yeoungseon/capstone/README.md

# capstone

Rocker-bogie 메커니즘을 이용한 식음료 배송 AMR

https://o365seoultech-my.sharepoint.com/:f:/g/personal/20110008_officestu_seoultech_ac_kr/EoON9EHYUJFPtbteJweAxmIBQ9wWiIXo9gfmbBEfmd8qZg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
