yeoungseon/capstone/2023/주간보고서/230330 주간보고서.pdf

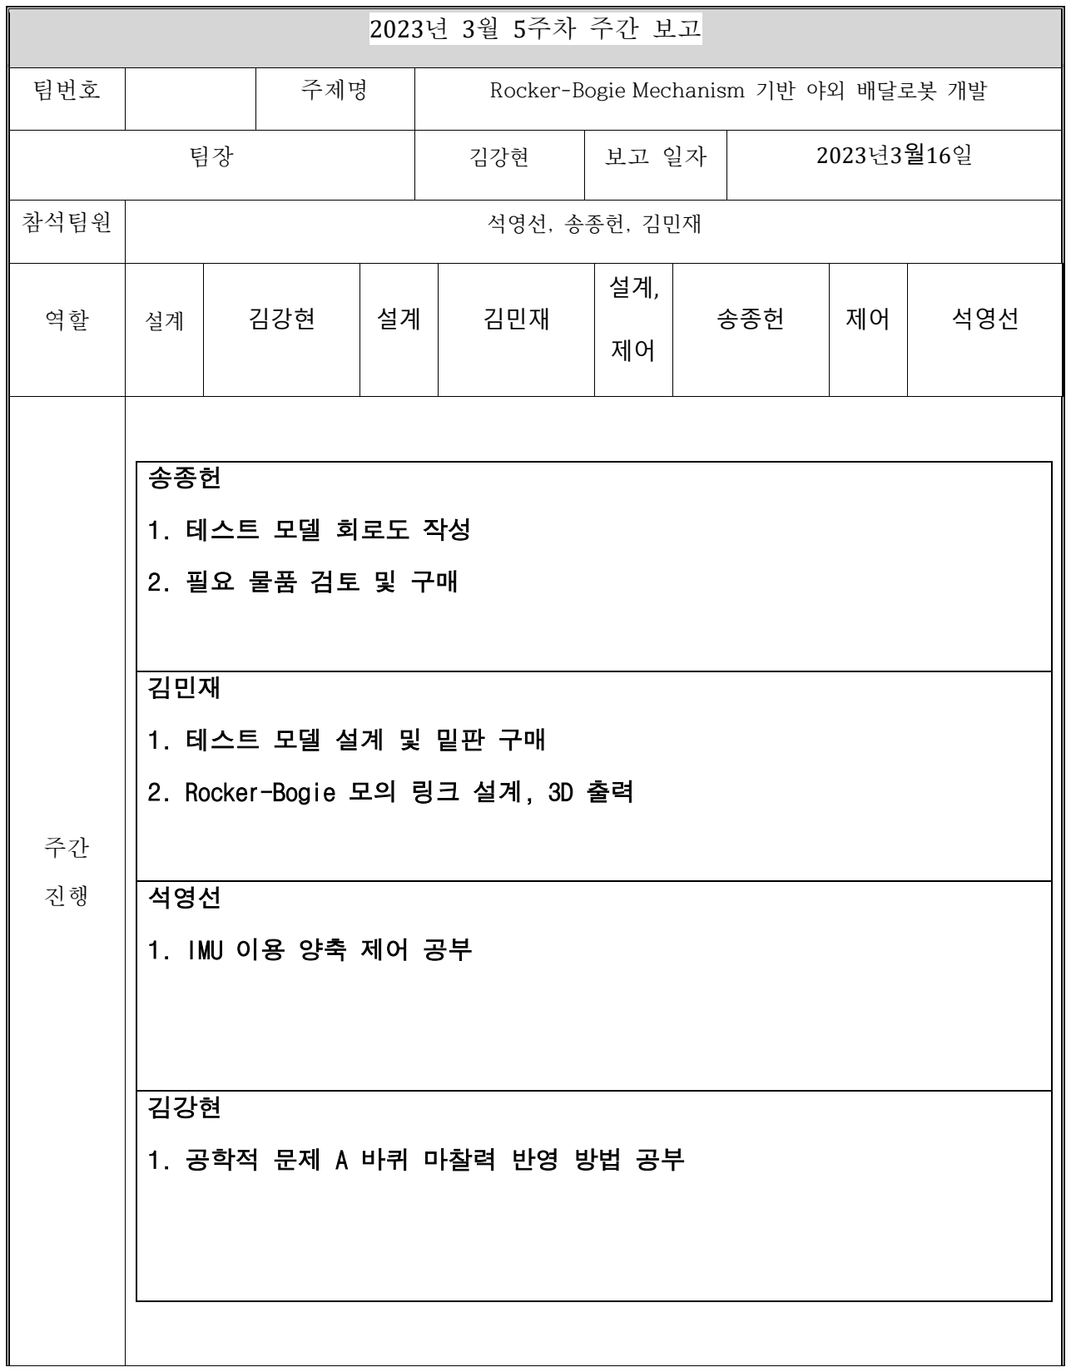
[picture p1: figure]
김강현; 참석팀원; 석영선, 송종헌, 김민재; 김민재; 송종헌; 석영선; 1. 테스트 모델 회로도 작성; 1. 테스트 모델 설계 및 밑판 구매; 2. Rocker-Bogie 모의 링크 설계, 3D 출력; 1. IMU 이용 양축 제어 공부; 1. 공학적 문제 A 바퀴 마찰력 반영 방법 공부

팀번호 | | 주제명 | Rocker-Bogie Mechanism 기반 야외 배달로봇 개발

차주

진행

송종헌

테스트 모델 회로 구성 및 작동 프로그래밍

김민재

테스트 모델 조립, 실 작품 라이다 및 배터리 배치 공부

석영선

테스트 모델 작동 프로그래밍, 카고 제어 공부

김강현

테스트 모델 조립
