yeoungseon/capstone/2023/주간보고서/230413 주간보고서.pdf

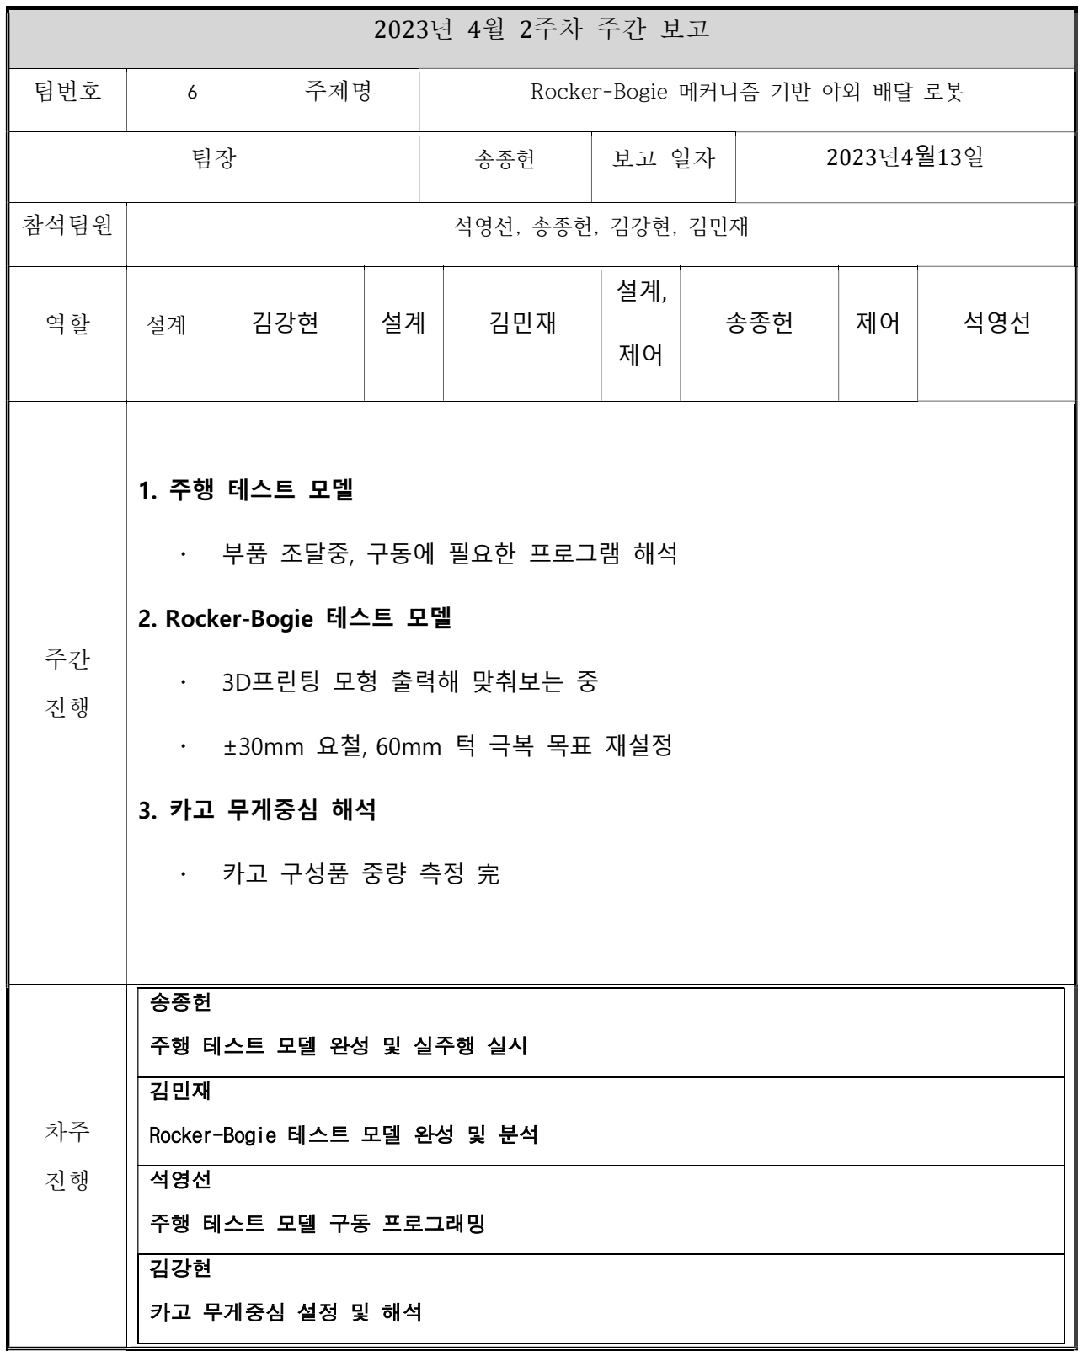
[picture p2: figure]
팀번호; 주제명; Rocker-Bogie 메커니즘 기반 야외 배달 로봇; 송종헌; 참석팀원; 석영선, 송종헌, 김강현, 김민재; 김강현; 김민재; 석영선; 1. 주행 테스트 모델; 부품 조달중, 구동에 필요한 프로그램 해석; 2. Rocker-Bogie 테스트 모델; 3D프린팅 모형 출력해 맞춰보는 중; ±30mm 요철, 60mm 턱 극복 목표 재설정; 3. 카고 무게중심 해석; 카고 구성품 중량 측정 完; 주행 테스트 모델 완성 및 실주행 실시; Rocker-Bogie 테스트 모델 완성 및 분석; 주행 테스트 모델 구동 프로그래밍; 카고 무게중심 설정 및 해석
