yeoungseon/capstone/2023/주간보고서/230512 주간보고서.pdf

2023년 5월 2주차 주간 보고

팀 번호 | 6 | 주제명 | Rocker-Bogie 메커니즘 기반 야외 배달 로봇
팀장 | 송종헌 | 보고 일자 | 2023. 5. 12.
참석 팀원 | 송종헌, 석영선, 김강현, 김민재
역학 | 설계 | 김강현 | 설계 | 김민재 | 설계, 제어 | 송종헌 | 제어 | 석영선
주간 진행 | 김강현 - 축 강성 해석, Cargo 화물 추가 배치 김민재 - 링크 조합에 대한 실험적 해석, 최적링크 도출 송종헌 - 모터 문제 해결, Cargo 프레임 도입 및 Sheet Metal Design 석영선 - 모터 문제 해결, Info Layer 작동상황 확인
차주 진행 | 김강현, 김민재, 송종헌 - 최종 상세 설계안 조율 석영선 - IMU 정보획득 스터디
