yeoungseon/capstone/2023/심사자료/1차발표 최종본.pdf

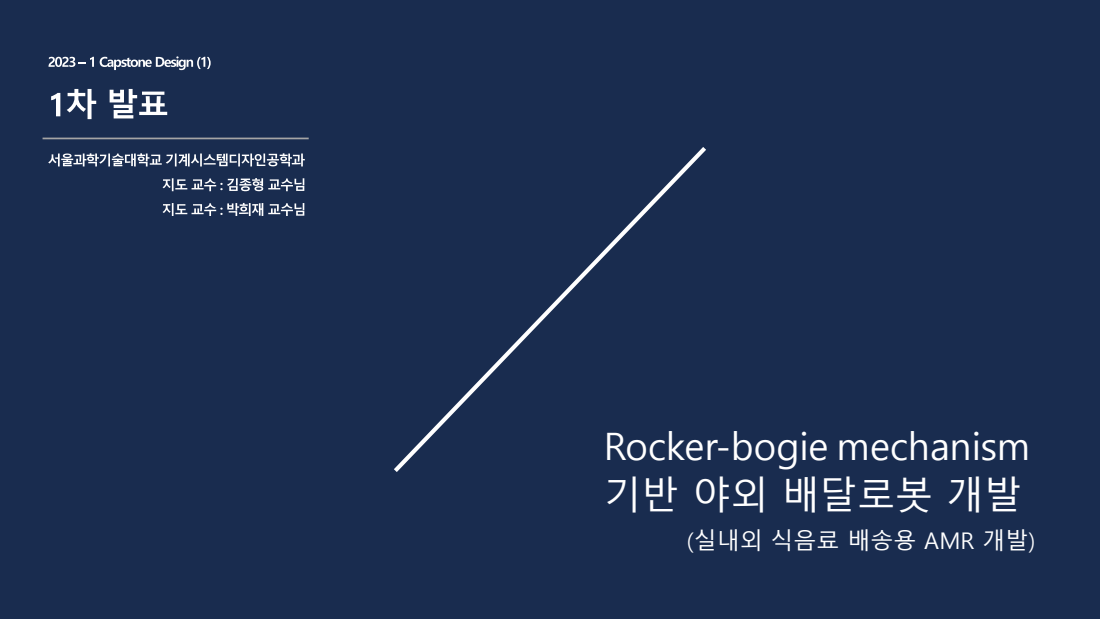
[picture p32: page 1]

Rocker-bogie mechanism
기반 야외 배달로봇 개발

(실내외 식음료 배송용 AMR 개발)

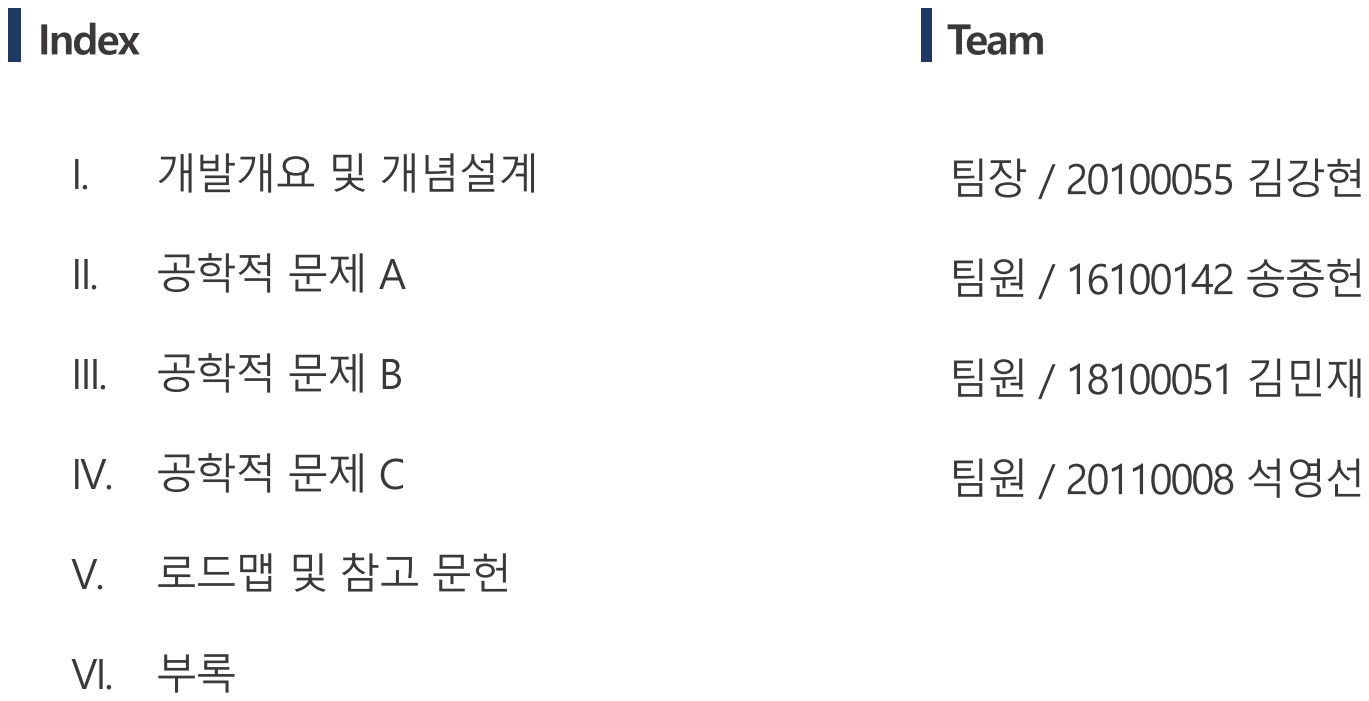
[picture p33: page 2]

### 개발 개요 및

### 개념 설계

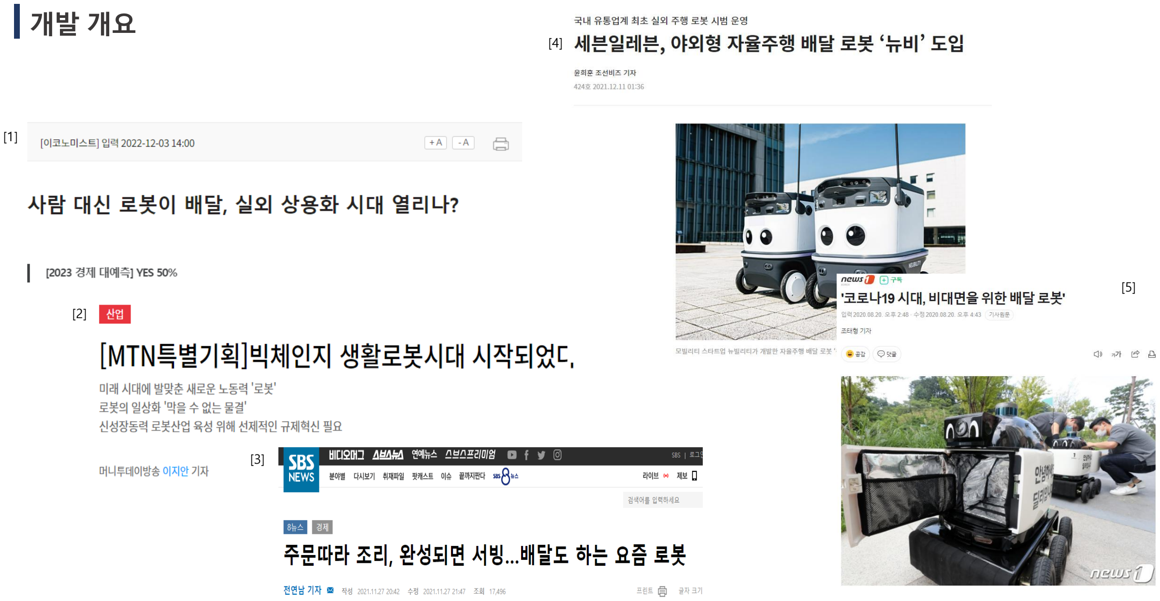
[picture p34: page 4]

[1]

[2]

[3]

[4]

[5]

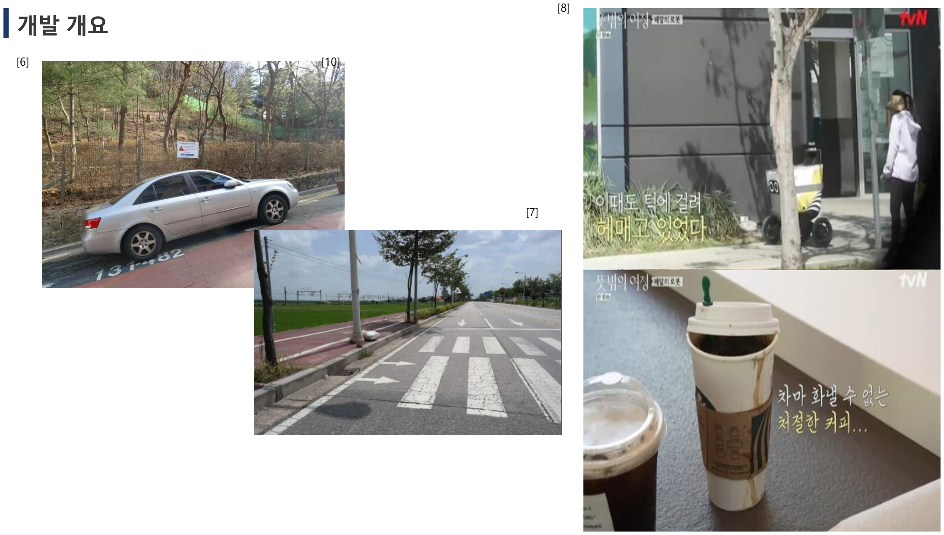
[picture p35: page 5]

[6] [10]

[7]

[8]

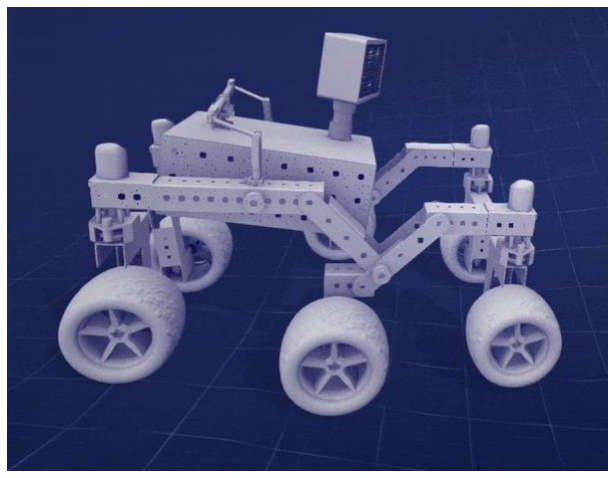
[picture p36: figure]

[9] [10]
+

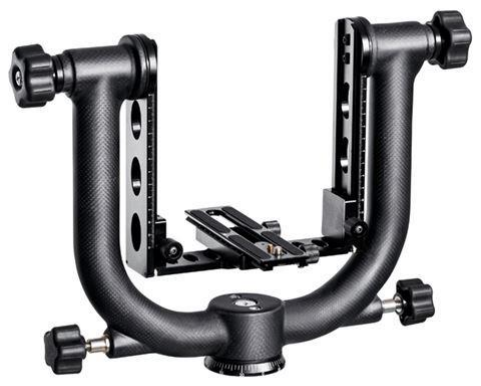
[picture p37: figure]

- 평탄하지 않은 지면에서 접지력과 안정성, 돌파 능력을 제공하는 Rocker-Bogie
- 외부에서 들어오는 기울어짐을 반대로 상쇄하는 Swing식 짐벌 메커니즘
- 이를 종합하면 더 다양한 환경에서 안정적인 배송이 가능할 것

- 시나리오 환경에서 험지 주파에 장애가 없는 동시에 흔들림을 최소화할 수 있 는 음료배달로봇
- 음식이 아닌 음료배달을 목적으로 선정한 이유 : 눈으로 확인하기 쉽고 스테빌 라이저 효과를 가장 잘 이용할 수 있을 것이라고 예상 됨

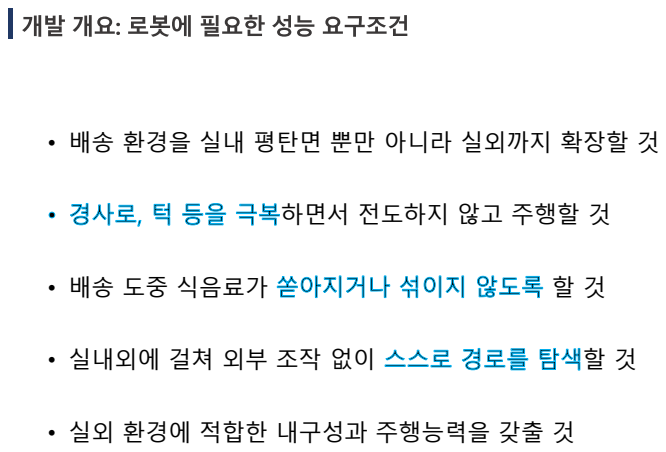
[picture p38: page 8]
• 배송 도중 식음료가; • 실내외에 걸쳐 외부 조작 없이

• 배송 환경을 실내 평탄면 뿐만 아니라 실외까지 확장할 것

하면서 전도하지 않고 주행할 것

• 실외 환경에 적합한 내구성과 주행능력을 갖출 것

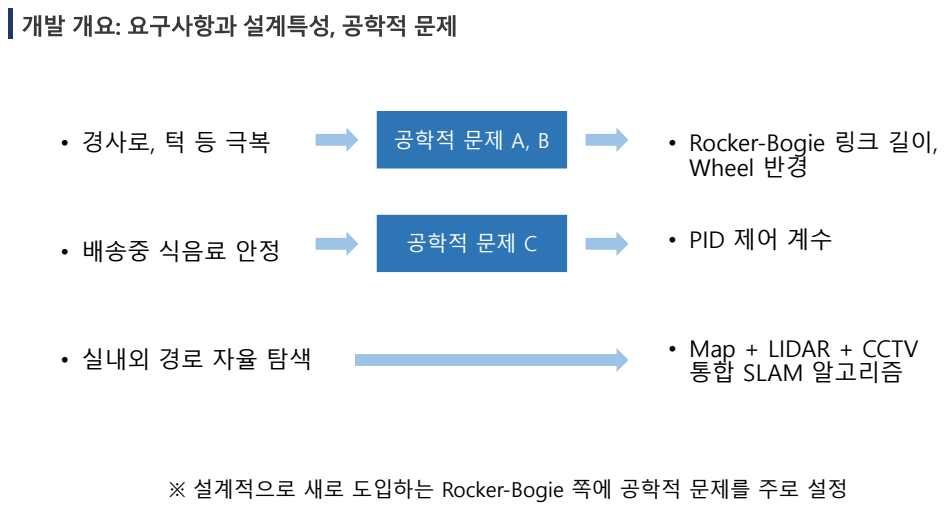
[picture p39: page 9]
• 경사로, 턱 등 극복; 공학적 문제 A, B; 공학적 문제 C

• Rocker-Bogie 링크 길이,
Wheel 반경

• PID 제어 계수

• 배송중 식음료 안정

• Map + LIDAR + CCTV
통합 SLAM 알고리즘

• 실내외 경로 자율 탐색

※ 설계적으로 새로 도입하는 Rocker-Bogie 쪽에 공학적 문제를 주로 설정

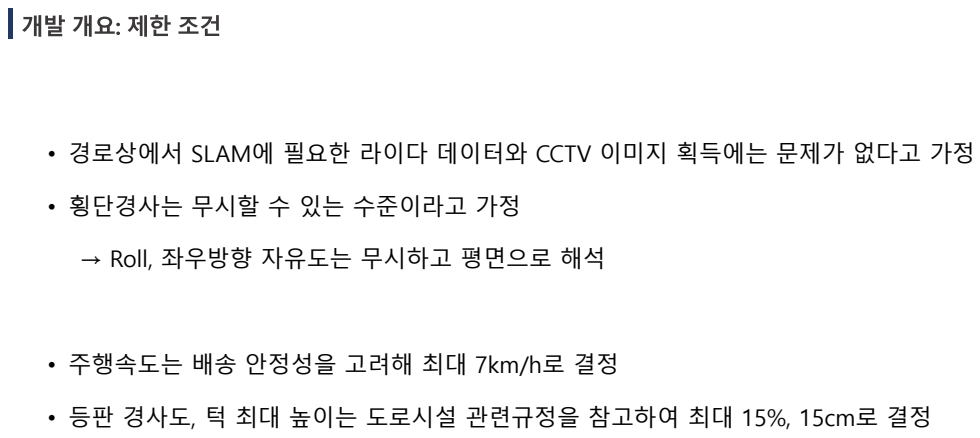
[picture p40: page 10]

• 경로상에서 SLAM에 필요한 라이다 데이터와 CCTV 이미지 획득에는 문제가 없다고 가정

• 횡단경사는 무시할 수 있는 수준이라고 가정

→ Roll, 좌우방향 자유도는 무시하고 평면으로 해석

• 주행속도는 배송 안정성을 고려해 최대 7km/h로 결정

• 등판 경사도, 턱 최대 높이는 도로시설 관련규정을 참고하여 최대 15%, 15cm로 결정

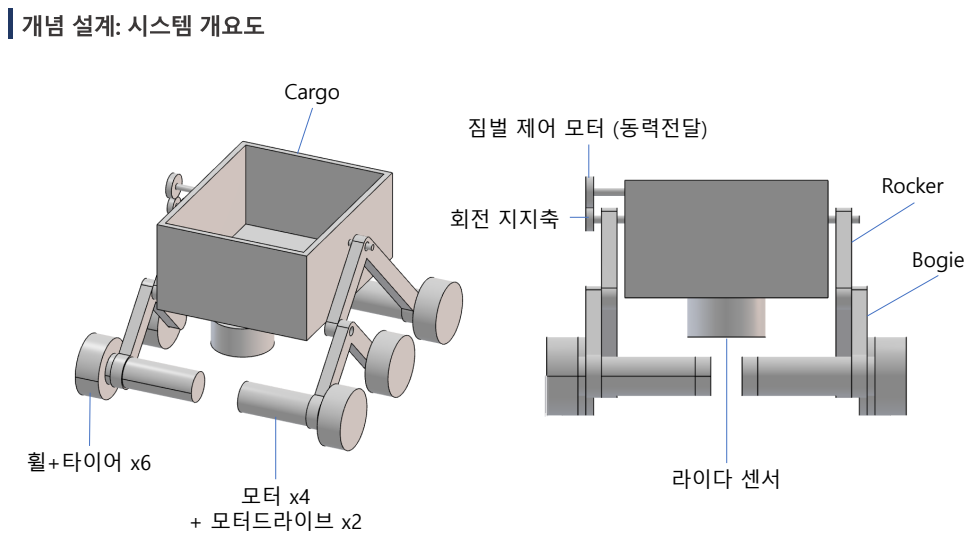
[picture p41: page 11]
회전 지지축; Cargo; + 모터드라이브 x2; 휠+타이어 x6; Rocker; Bogie

짐벌 제어 모터 (동력전달)

라이다 센서 모터 x4

- CCTV가 갖춰진 실내에서 모의 주행 환경으로 테스트
- A - 경사로 극복 → B - 턱 극복 → C - 장애물 회피
- 전체 과정에서 경로 탐색, 음료의 안정성 유지를 지속 수행
🏴 | 🏴

평가: 배송된 음료의 상태,
배송 중 경로 이탈 여부

A코스: 15% 경사면

B코스: 15cm 턱

C코스: 장애물 인식·회피

- 링크와 다중 구동륜을 이용한 Rocker-Bogie 메커니즘을 사용

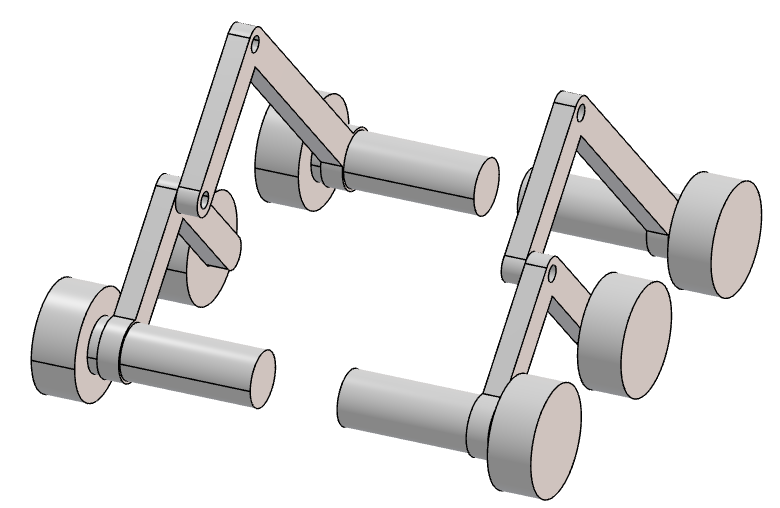
[picture p42: figure]
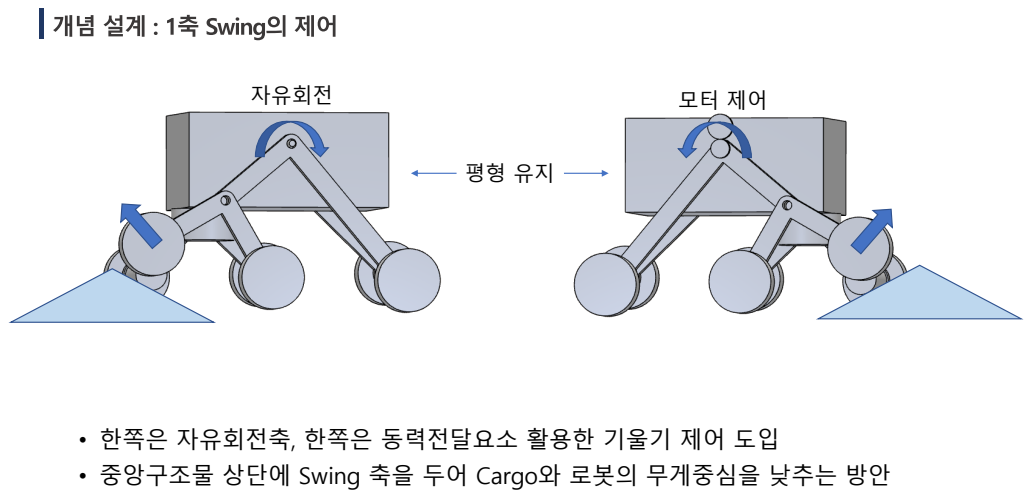
[picture p43: page 14]
자유회전

• 한쪽은 자유회전축, 한쪽은 동력전달요소 활용한 기울기 제어 도입
• 중앙구조물 상단에 Swing 축을 두어 Cargo와 로봇의 무게중심을 낮추는 방안

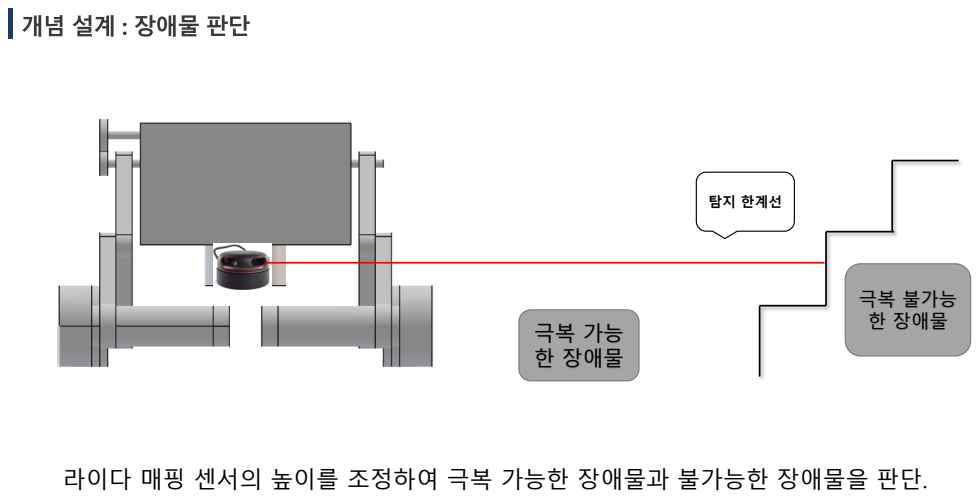
[picture p44: page 15]
극복 가능 한 장애물; 탐지 한계선; 극복 불가능 한 장애물

라이다 매핑 센서의 높이를 조정하여 극복 가능한 장애물과 불가능한 장애물을 판단.

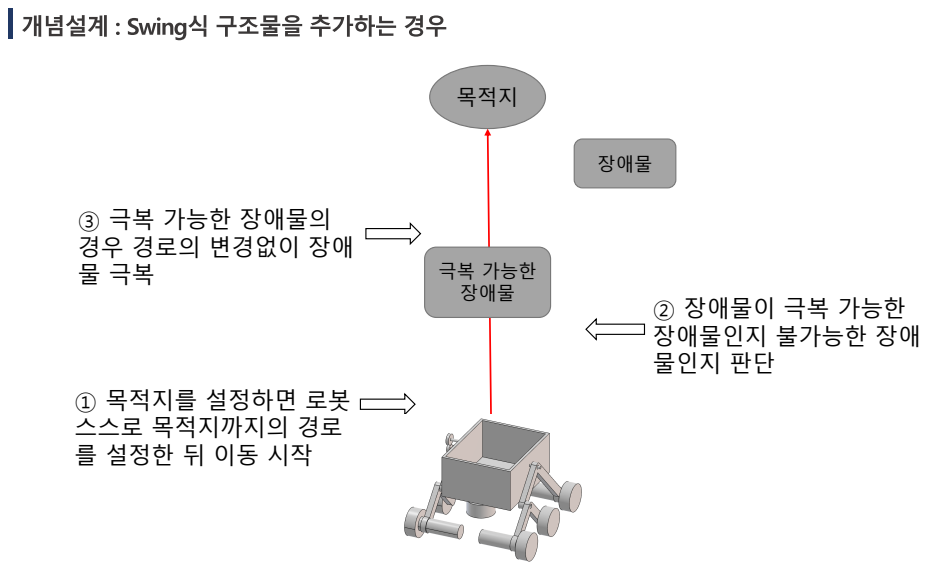
[picture p45: page 16]
극복 가능한 장애물; 목적지; 장애물

③ 극복 가능한 장애물의
경우 경로의 변경없이 장애

② 장애물이 극복 가능한
장애물인지 불가능한 장애
물인지 판단

① 목적지를 설정하면 로봇
스스로 목적지까지의 경로
를 설정한 뒤 이동 시작

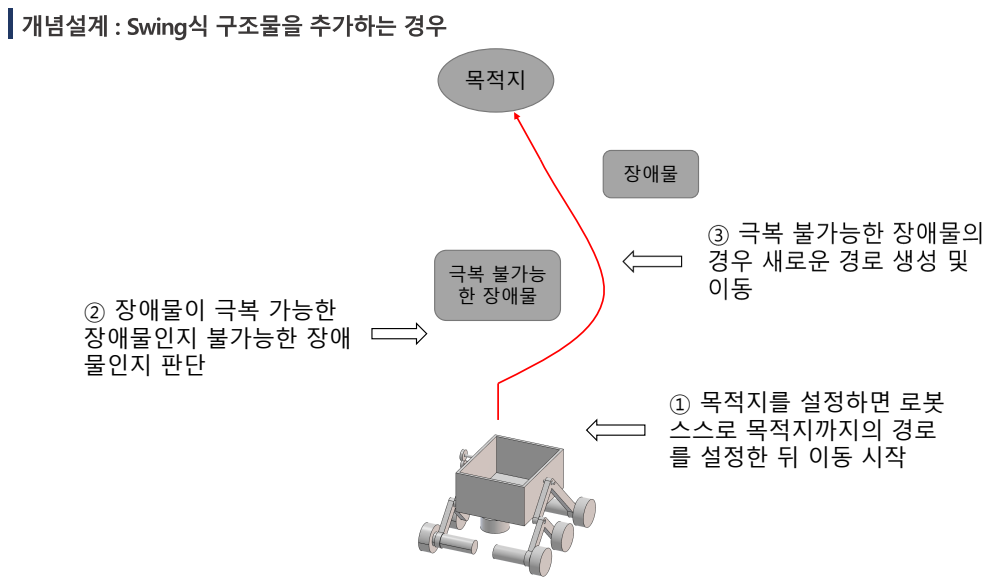
[picture p46: page 17]
극복 불가능 한 장애물; 목적지; 장애물

② 장애물이 극복 가능한
장애물인지 불가능한 장애
물인지 판단

① 목적지를 설정하면 로봇
스스로 목적지까지의 경로
를 설정한 뒤 이동 시작

### 공학적 문제 A

최대 등판각 대응 링크 최적화

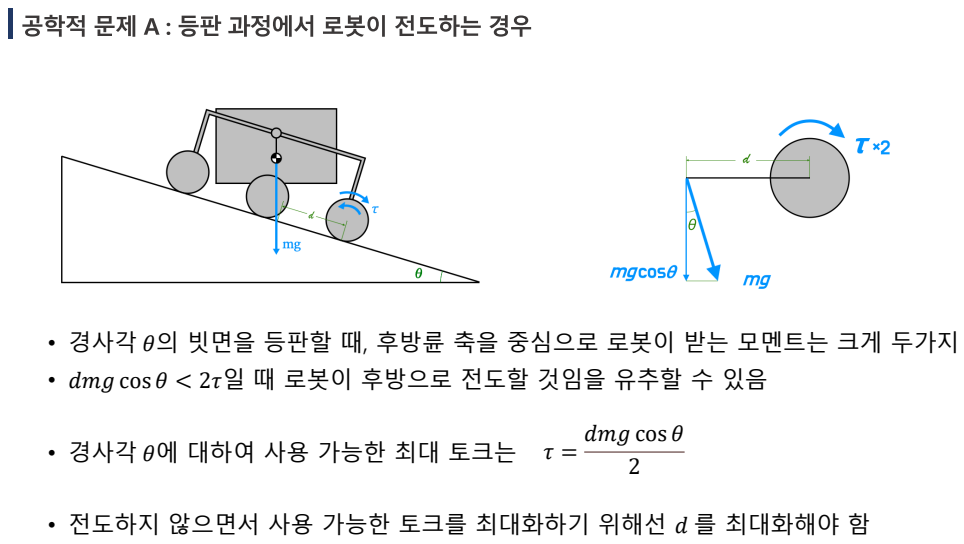
[picture p47: page 19]
dmg cos θ 2

• 경사각 θ의 빗면을 등판할 때, 후방륜 축을 중심으로 로봇이 받는 모멘트는 크게 두가지
• dmg cos θ < 2τ일 때 로봇이 후방으로 전도할 것임을 유추할 수 있음

• 경사각 θ에 대하여 사용 가능한 최대 토크는

• 전도하지 않으면서 사용 가능한 토크를 최대화하기 위해선 d 를 최대화해야 함

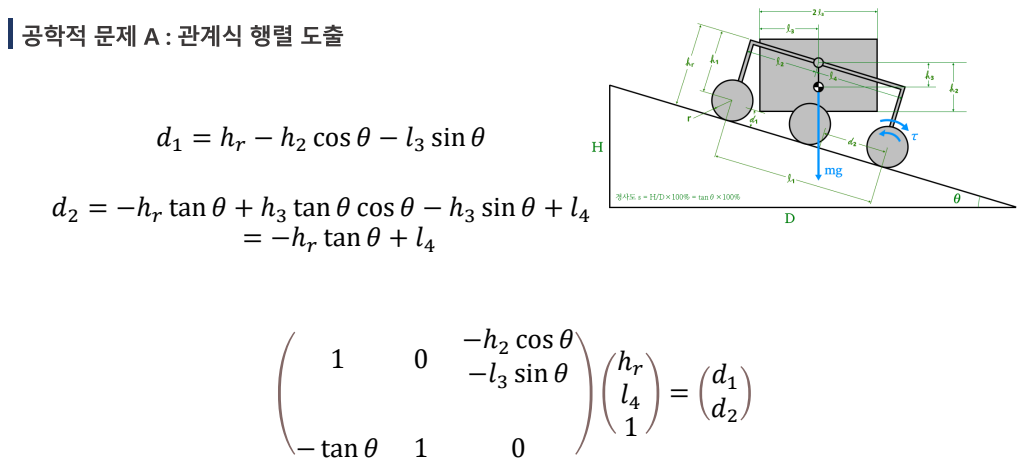
[picture p48: page 20]
tan θ + l4; −ℎ2 cos θ −l3 sin θ; − tan θ

d1 = ℎr − ℎ2 cos θ − l3 sin θ

tan θ + ℎ3 tan θ cos θ − ℎ3 sin θ + l4

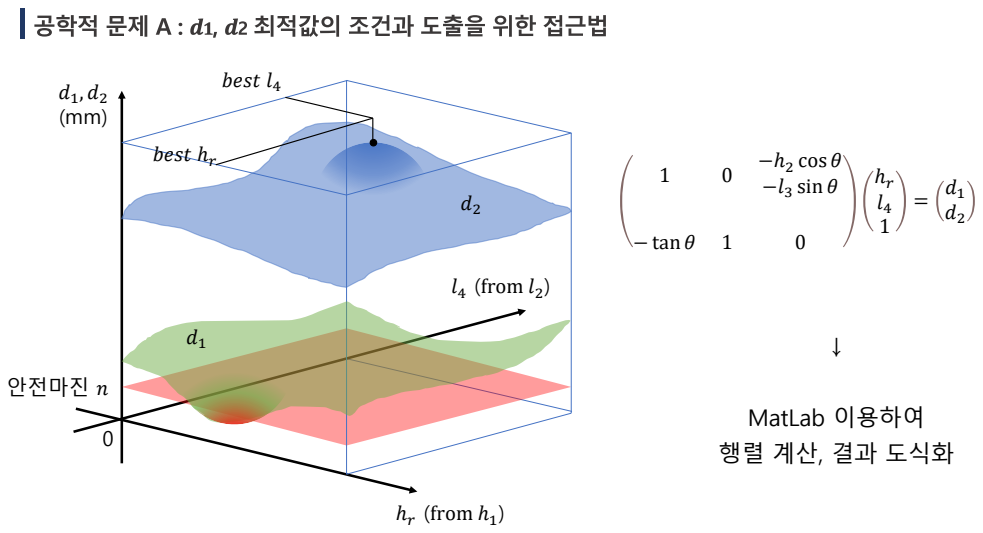
[picture p49: page 21]
안전마진 n; (from ℎ1); l4 (from l2); best l4; best ℎr; −ℎ2 cos θ −l3 sin θ; − tan θ

MatLab 이용하여
행렬 계산, 결과 도식화

### 공학적 문제 B

턱 극복 대응 링크 및 바퀴 크기 최적화

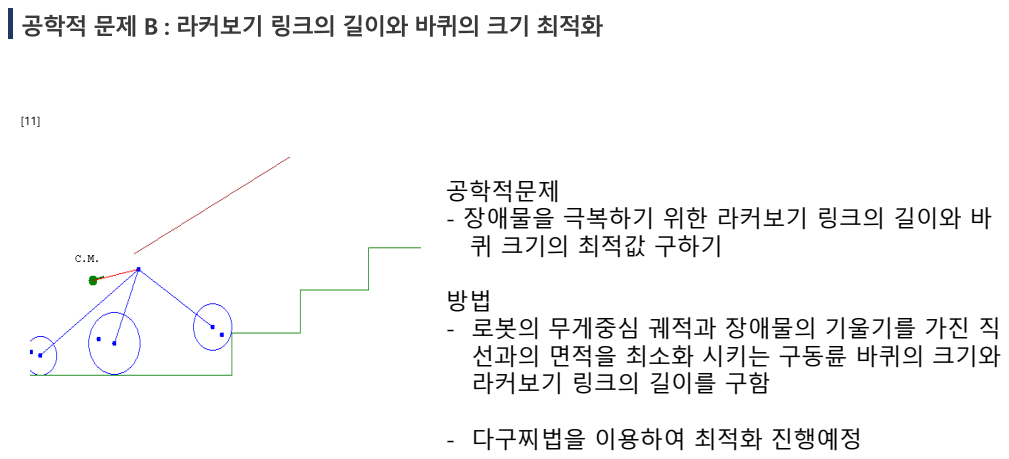
[picture p50: page 23]

공학적문제
- 장애물을 극복하기 위한 라커보기 링크의 길이와 바
퀴 크기의 최적값 구하기

- 로봇의 무게중심 궤적과 장애물의 기울기를 가진 직
선과의 면적을 최소화 시키는 구동륜 바퀴의 크기와
라커보기 링크의 길이를 구함

- 다구찌법을 이용하여 최적화 진행예정

### 공학적 문제 C

IMU를 이용한 Cargo 평형 제어

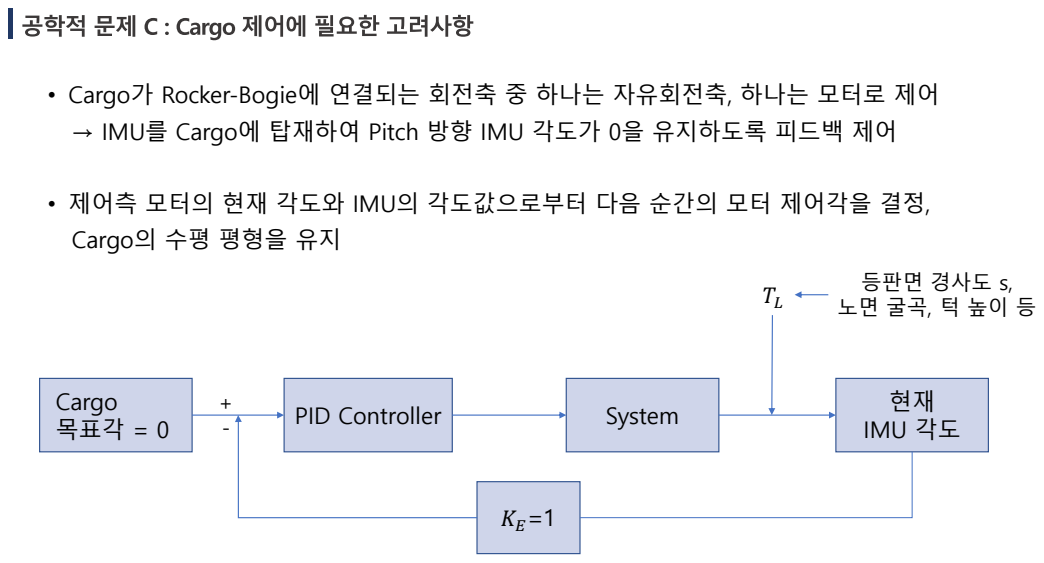
[picture p51: page 25]
Cargo; 목표각 = 0; PID Controller; System; IMU 각도

• Cargo가 Rocker-Bogie에 연결되는 회전축 중 하나는 자유회전축, 하나는 모터로 제어
→ IMU를 Cargo에 탑재하여 Pitch 방향 IMU 각도가 0을 유지하도록 피드백 제어

• 제어측 모터의 현재 각도와 IMU의 각도값으로부터 다음 순간의 모터 제어각을 결정,
Cargo의 수평 평형을 유지

등판면 경사도 s,

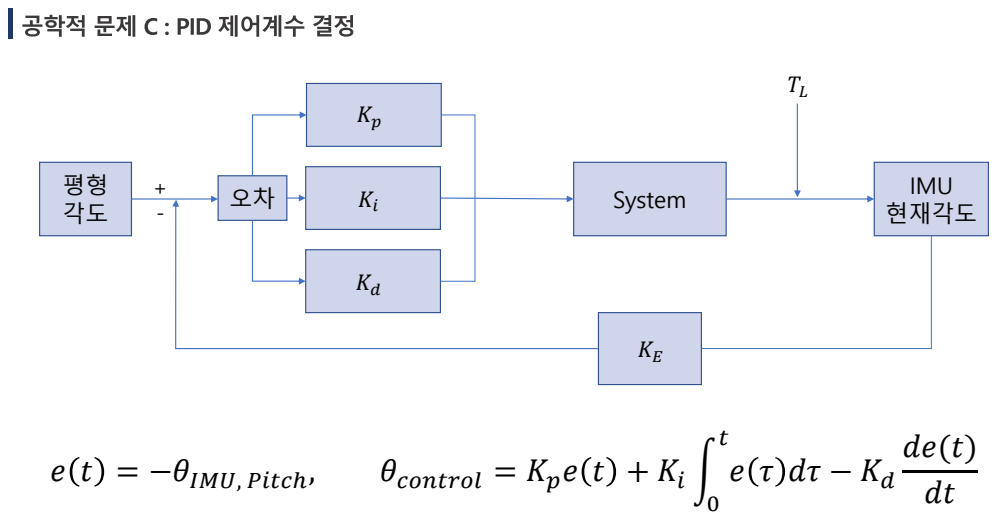
[picture p52: page 26]
System; IMU; 현재각도 오차; e t = −θIMU, Pitcℎ,; θcontrol = Kpe t + Ki න

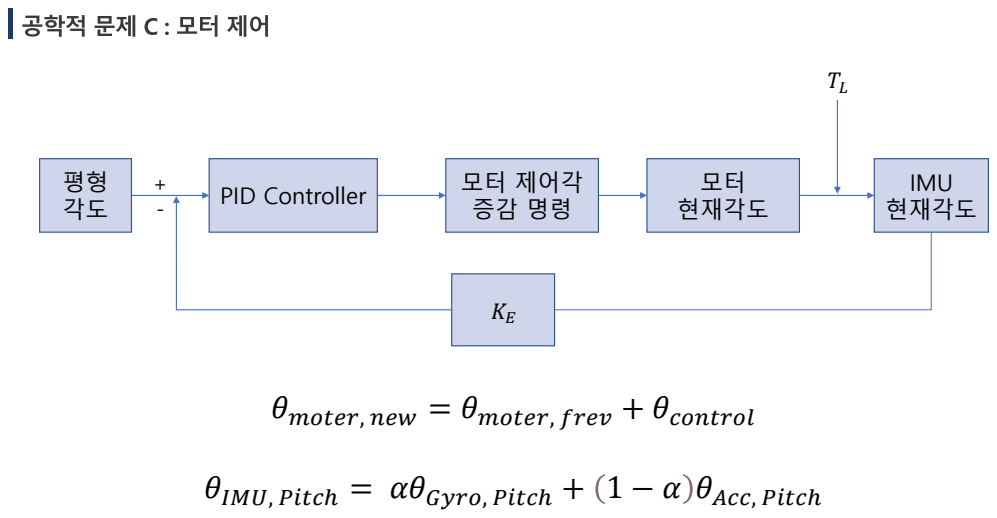
[picture p53: page 27]
모터 현재각도; IMU 현재각도; PID Controller; 모터 제어각

θmoter, new = θmoter, frev + θcontrol

θIMU, Pitcℎ = αθGyro, Pitcℎ + 1 − α θAcc, Pitcℎ

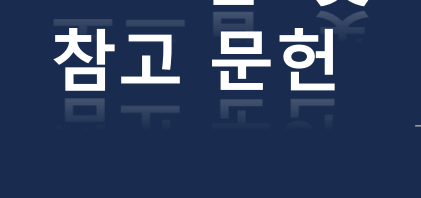
[picture p54: figure]

로드맵 및

구분 | 대분류 | 진행일정
4 | 5 | 6 | 7 | 8 | 9 | 10 | 11
1 | 2 | 3 | 4 | 1 | 2 | 3 | 4 | 1 | 2 | 3 | 4 | 1 | 2 | 3 | 4 | 1 | 2 | 3 | 4 | 1 | 2 | 3 | 4 | 1 | 2 | 3 | 4 | 1 | 2 | 3 | 4
제어부 | -로봇 시스템
| - Rocker-bogie | 설계
| | 제작
| - Cargo | 설계
| | 제작
| - 회로 | 설계
| | 제작

설계부

구분 | 대분류 | 소분류 | 역할분담
제어부 | -로봇 시스템 | IMU Swing PID | 송종헌, 석영선
| | CCTV+SLAM | 석영선
| | ROS 통합 | 송종헌 , 석영선
| | 라이다 | 석영선
| | 모터제어 | 송종헌
| - Rocker -bogie | 턱 대응 최적화 | 김민재
| | 등판각 대응 최적화 | 송종헌
| | Bogie 형상 | 김민재
| | Wheel 선정, 모터 장착 | 김강현
| - Cargo | Body 설계 | 김민재
| | 축 Swing 설계 1 | 김강현
| | 무게중심해석 | 송종헌
| - 회로 | 모터, 배터리, 문워커 배치 | 김강현
| | NUC -모터 | 김민재
| | IMU | 김강현

설계부

- [1] 사람 대신 로봇이 배달, 실외 상용화 시대 열리나?

(https://economist.co.kr/article/view/ecn202212030017)
- [2] 빅체인지 생활로봇시대 시작되었다

(https://news.mtn.co.kr/news-detail/2022120915065365886)
- [3] 주문따라 조리, 완성되면 서빙…배달도 하는 요즘 로봇

(https://news.sbs.co.kr/news/endPage.do?news_id=N1006549254&plink=ORI&cooper=NAVER)
- [4] 국내 유통업계 최초 실외 주행 로봇 시범 운영 세븐일레븐, 야외형 자율주행 배달 로봇 ‘뉴비’ 도입 (https://economychosun.com/site/data/html_dir/2021/12/11/2021121100017.html)
- [5] '코로나19 시대, 비대면을 위한 배달 로봇’

(https://n.news.naver.com/mnews/article/421/0004824718)
- [6] 길가의 돌·나무조각 안 써도 된다…강남구, 경사주차장 '고임목' 지급 - 경향신문 (khan.co.kr)

( https://m.khan.co.kr/national/national-general/article/202103251853001#c2b)
- [7] 횡단보도가 설치됐으나 차도와 인도를 구분하는 경계석은 여전히 높다.

(http://www.gjtimes.co.kr/news/photoView.html?idxno=17841)
- [8] tvN ‘뜻밖의 여정’ 캡처 (22.05.22 방영분)
- [9] Deploying on Mars: NASA-JPL Open Source Rover

(https://www.freedomrobotics.com/blog/building-the-nasa-jpl-open-source-rover)

- [10] Sevenoak Carbon Gimbal Swing Panorama Head SK-GH10, 178,33

(https://www.mediaresort.de/Sevenoak-Carbon-Gimbal-Swing-Panorama-Head-SK-GH10)
- [11] 라커보기 구조의 로봇 무게중심이 이동하는 모습

(qcnqs.gif (573×266) (imgur.com))

- McGraw Hill – Shigly’s Mechanical Engineering Design
- "배달로봇 인도주행 가능 법적 근거 마련" - 정보통신신문 (http://www.koit.co.kr/news/articleView.html?idxno=101849)
- https://www.law.go.kr/법령/도로의구조ㆍ시설기준에관한규칙/(20211213,00922,20211213)/제25조
- https://www.law.go.kr/법령/도로의구조ㆍ시설기준에관한규칙/(20211213,00922,20211213)/제16조
- 2022-2 자동화시스템 강의 자료

부록

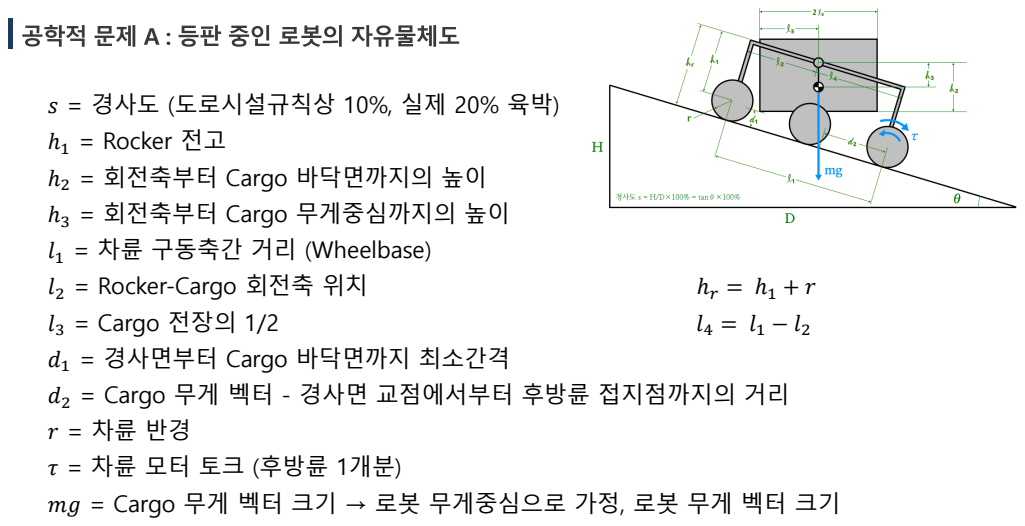
[picture p55: page 34]
l2 = Rocker-Cargo 회전축 위치; l3 = Cargo 전장의 1/2

s = 경사도 (도로시설규칙상 10%, 실제 20% 육박)
ℎ1 = Rocker 전고
ℎ2 = 회전축부터 Cargo 바닥면까지의 높이
ℎ3 = 회전축부터 Cargo 무게중심까지의 높이
l1 = 차륜 구동축간 거리 (Wheelbase)
d1 = 경사면부터 Cargo 바닥면까지 최소간격
d2 = Cargo 무게 벡터 - 경사면 교점에서부터 후방륜 접지점까지의 거리
τ = 차륜 모터 토크 (후방륜 1개분)
mg = Cargo 무게 벡터 크기 → 로봇 무게중심으로 가정, 로봇 무게 벡터 크기

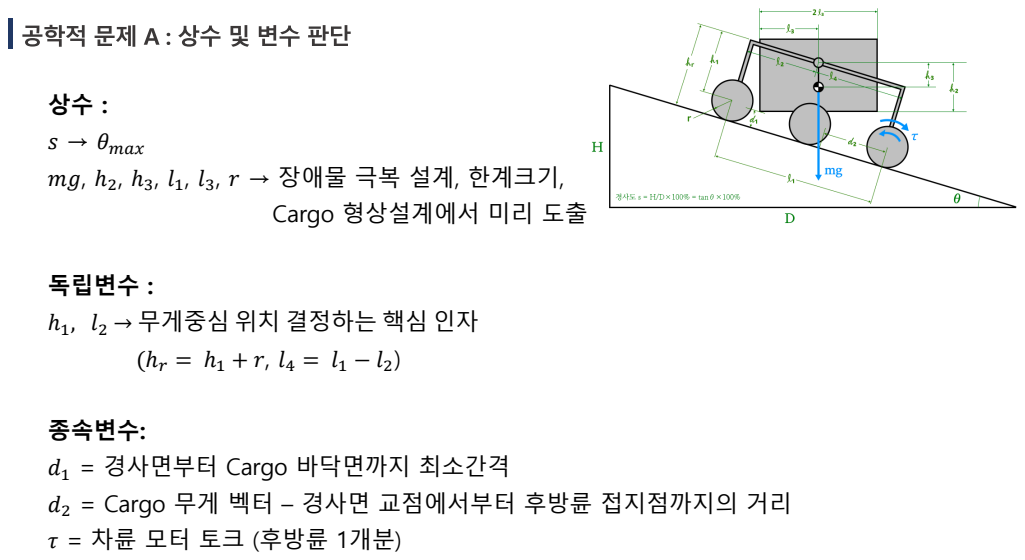
[picture p56: page 35]

s → θmax
mg, ℎ2, ℎ3, l1, l3, r → 장애물 극복 설계, 한계크기,

Cargo 형상설계에서 미리 도출

독립변수 :
ℎ1, l2 → 무게중심 위치 결정하는 핵심 인자

종속변수:
d1 = 경사면부터 Cargo 바닥면까지 최소간격
d2 = Cargo 무게 벡터 – 경사면 교점에서부터 후방륜 접지점까지의 거리
τ = 차륜 모터 토크 (후방륜 1개분)

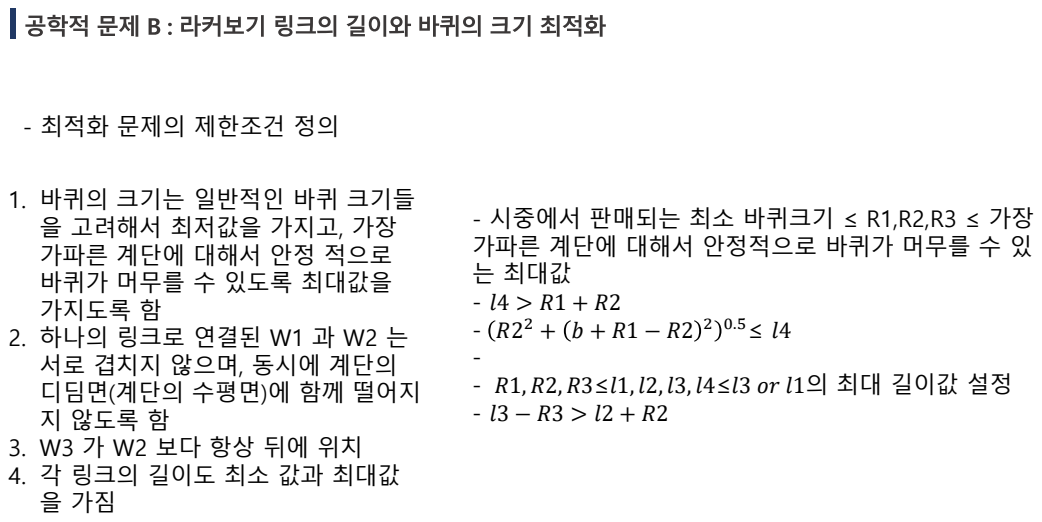
[picture p57: page 36]

- 최적화 문제의 제한조건 정의

1. 바퀴의 크기는 일반적인 바퀴 크기들
을 고려해서 최저값을 가지고, 가장
가파른 계단에 대해서 안정 적으로
바퀴가 머무를 수 있도록 최대값을
가지도록 함
2. 하나의 링크로 연결된 W1 과 W2 는
서로 겹치지 않으며, 동시에 계단의
디딤면(계단의 수평면)에 함께 떨어지
지 않도록 함
4. 각 링크의 길이도 최소 값과 최대값

- 시중에서 판매되는 최소 바퀴크기 ≤ R1,R2,R3 ≤ 가장
가파른 계단에 대해서 안정적으로 바퀴가 머무를 수 있
는 최대값
- R1, R2, R3≤l1, l2, l3, l4≤l3 or l1의 최대 길이값 설정

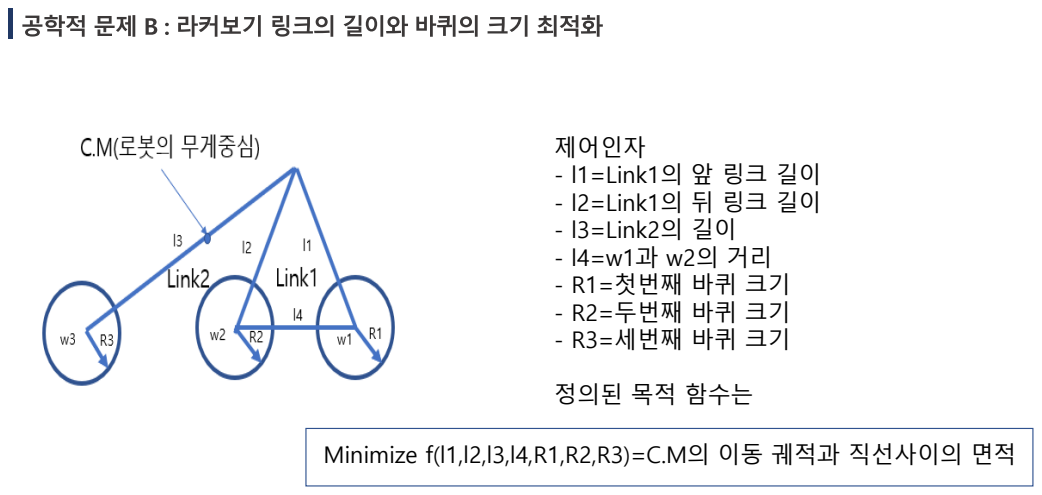
[picture p58: page 37]

제어인자
- l1=Link1의 앞 링크 길이
- l2=Link1의 뒤 링크 길이
- l3=Link2의 길이
- R1=첫번째 바퀴 크기
- R2=두번째 바퀴 크기
- R3=세번째 바퀴 크기

정의된 목적 함수는

Minimize f(l1,l2,l3,l4,R1,R2,R3)=C.M의 이동 궤적과 직선사이의 면적
