yeoungseon/capstone/2023/주간보고서/주간보고서 양식.docx

2023년 2월 4주차 주간 보고
팀번호 | | | 주제명
팀장 | | | | | | | 보고 일자 | | | 2023년 2월 23일
참석팀원
역할
주간 진행
차주 진행
