yeoungseon/capstone/2023/주간보고서/230407 주간보고서.pdf

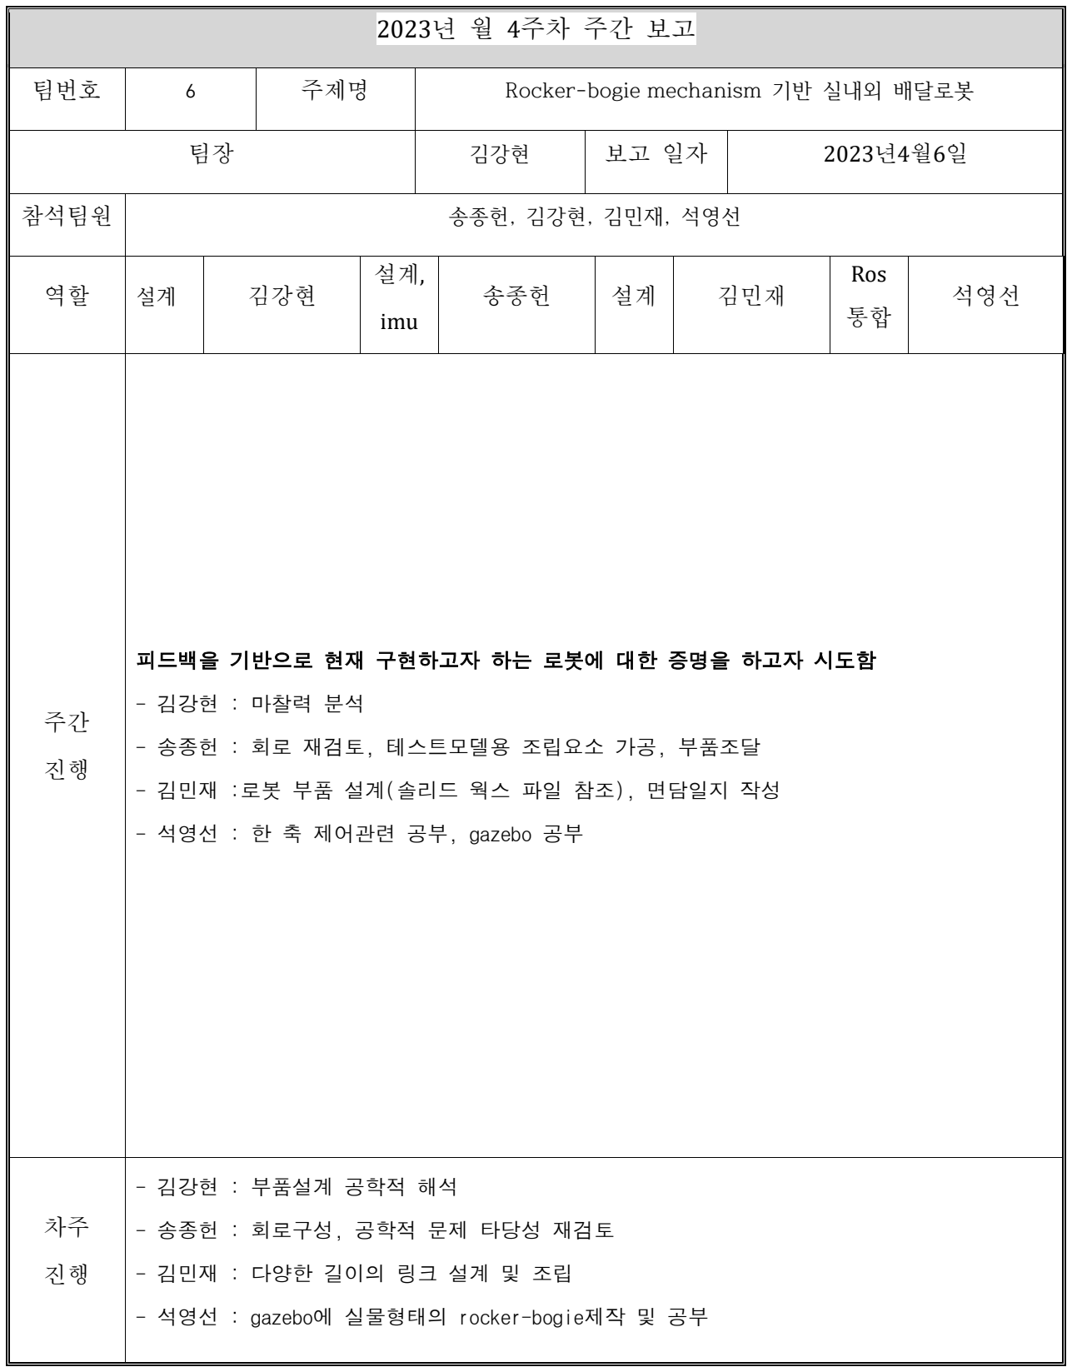
[picture p92: figure]
김강현; 참석팀원; 송종헌, 김강현, 김민재, 석영선; 설계, imu; 송종헌; 김민재; Ros 통합; 석영선; - 김강현 : 마찰력 분석; - 송종헌 : 회로 재검토, 테스트모델용 조립요소 가공, 부품조달; - 김민재 :로봇 부품 설계(솔리드 웍스 파일 참조), 면담일지 작성; - 석영선 : 한 축 제어관련 공부, gazebo 공부; - 김강현 : 부품설계 공학적 해석; - 송종헌 : 회로구성, 공학적 문제 타당성 재검토; - 김민재 : 다양한 길이의 링크 설계 및 조립

팀번호 | 6 | 주제명 | Rocker-bogie mechanism 기반 실내외 배달로봇

피드백을 기반으로 현재 구현하고자 하는 로봇에 대한 증명을 하고자 시도함

- 석영선 : gazebo에 실물형태의 rocker-bogie제작 및 공부
