yeoungseon/capstone/2023/주간보고서/230309 주간보고서.pdf

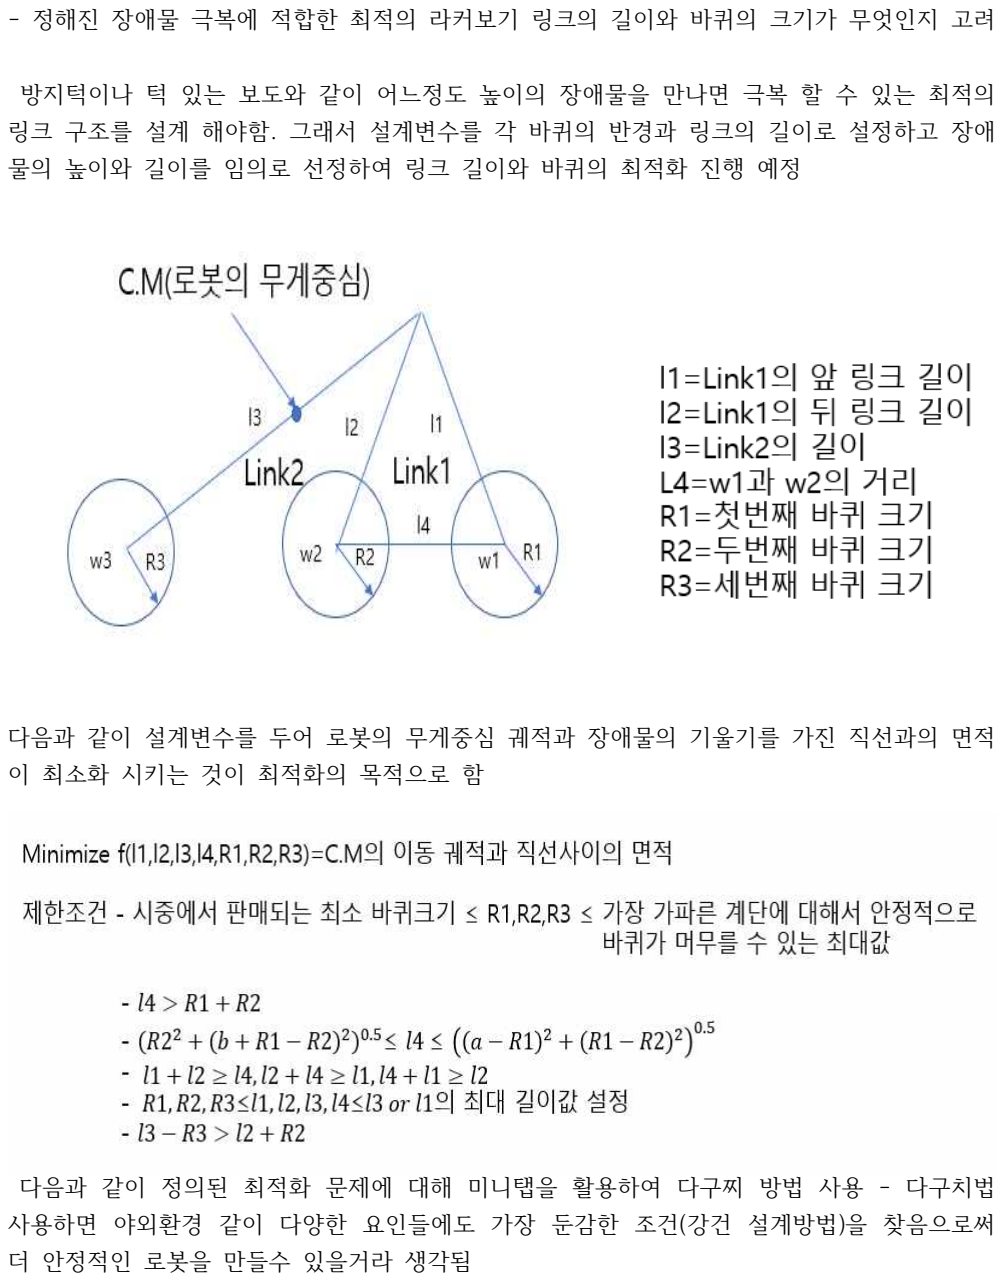
[picture p93: page 1]

- 정해진 장애물 극복에 적합한 최적의 라커보기 링크의 길이와 바퀴의 크기가 무엇인지 고려

방지턱이나 턱 있는 보도와 같이 어느정도 높이의 장애물을 만나면 극복 할 수 있는 최적의 링크 구조를 설계 해야함. 그래서 설계변수를 각 바퀴의 반경과 링크의 길이로 설정하고 장애 물의 높이와 길이를 임의로 선정하여 링크 길이와 바퀴의 최적화 진행 예정

다음과 같이 설계변수를 두어 로봇의 무게중심 궤적과 장애물의 기울기를 가진 직선과의 면적 이 최소화 시키는 것이 최적화의 목적으로 함

다음과 같이 정의된 최적화 문제에 대해 미니탭을 활용하여 다구찌 방법 사용 - 다구치법 사용하면 야외환경 같이 다양한 요인들에도 가장 둔감한 조건(강건 설계방법)을 찾음으로써 더 안정적인 로봇을 만들수 있을거라 생각됨

경사면 등판 능력을 확보하면서 차고를 낮추는 설계 도출

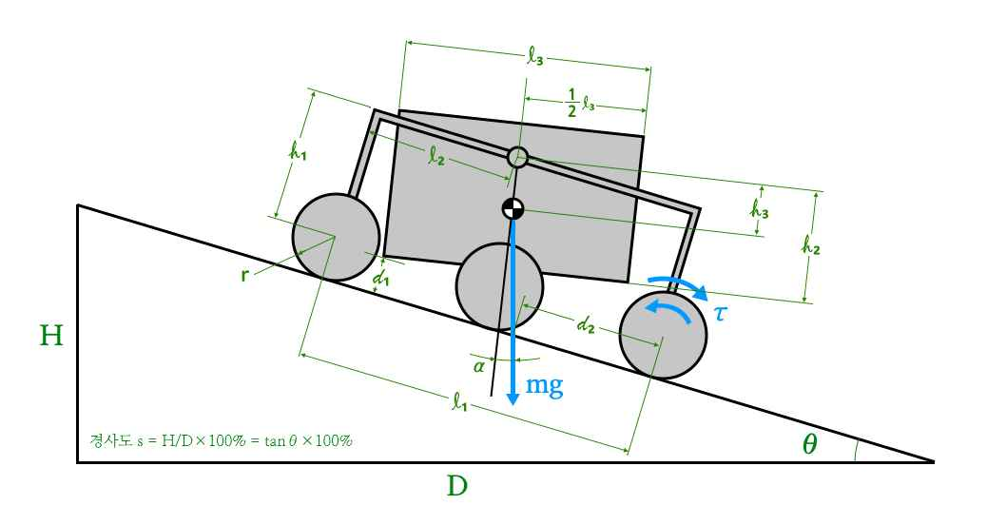
[picture p94: figure]

- = 경사도 (도로시설규칙상 10%)

= 차륜 구동축간 거리 (Wheel Base)

= Rocker-Cargo 회전축 위치

= Cargo 전장

= Rocker 전고

= 회전축부터 Cargo 바닥면까지의 높이

= 회전축부터 Cargo 무게중심까지의 높이

= 경사면부터 Cargo 바닥면까지 최소간격

= Cargo 무게 벡터 - 경사면 교점에서부터 후방륜 접지점까지의 거리

- = 차륜 반경
- = Cargo 최대 틸트 각도
- = 차륜 모터 토크 (후방륜 1개분)

= Cargo 무게 벡터 크기

,

,

,

,

, , 는 제반설계에서 미리 결정해야 하는 상수이다.

,

, , 는 최적화를 위해 조정 가능한 독립변수이다.

, 는 종속변수이다.

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
