yeoungseon/capstone/2023/발표자료/주간발표-2(02.24).pdf

2023-02-25

# 2023년 Capston Design

2023-02-24

# 야외용 배달로봇의 경쟁력

1

2

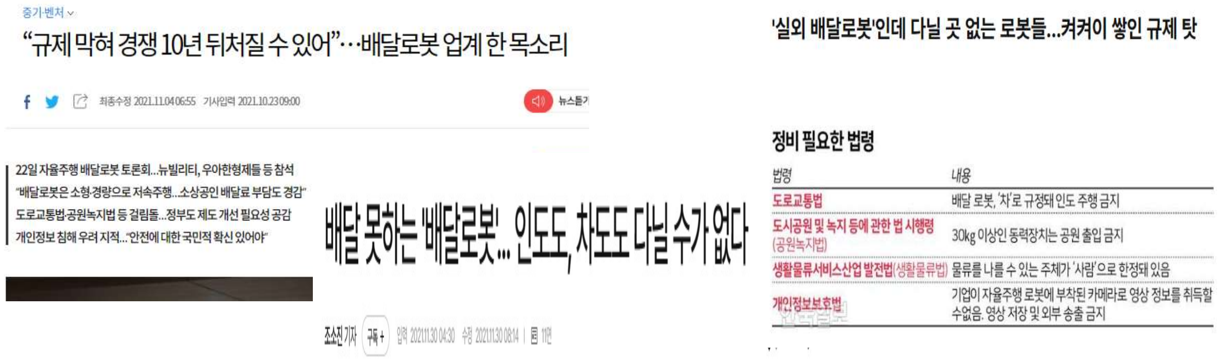
[picture p95: figure]

# 야외용 배달로봇의 경쟁력

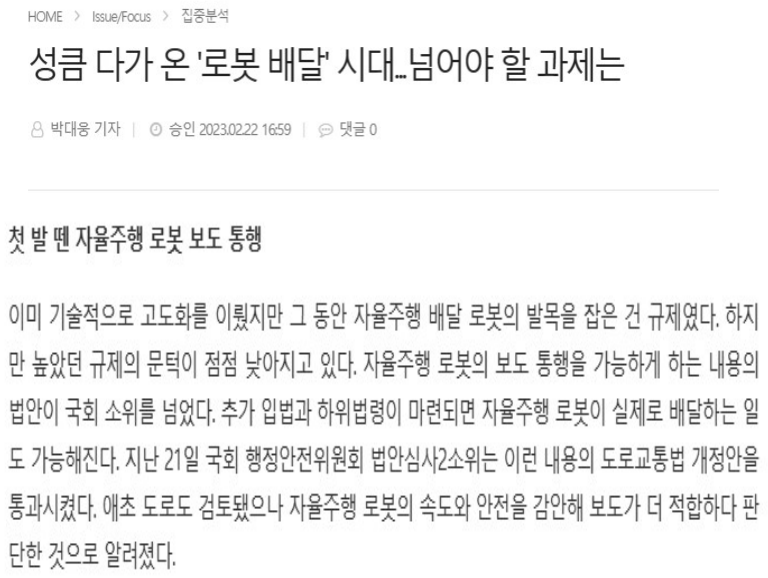
[picture p96: figure]
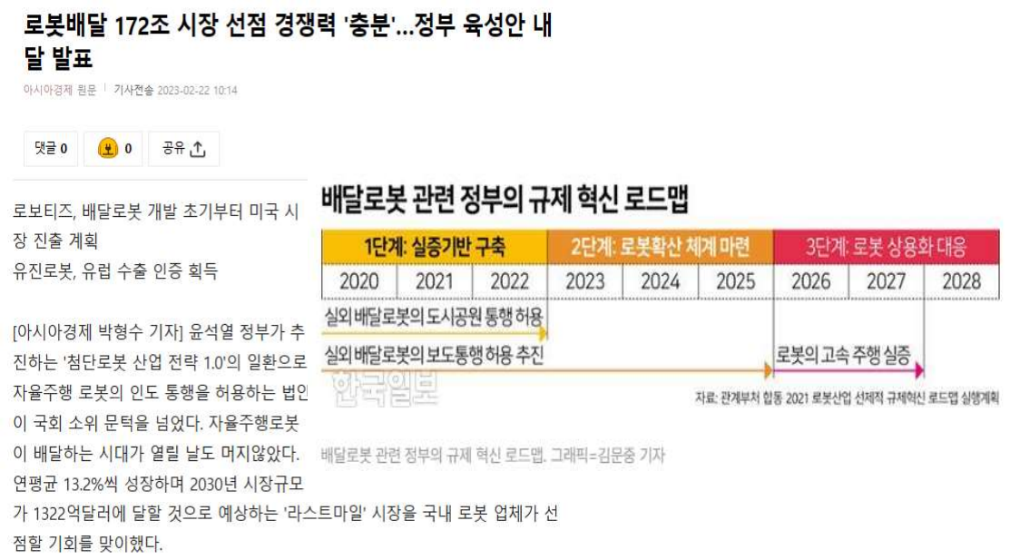
[picture p97: figure]

# 야외용 배달로봇의 장점

3

4

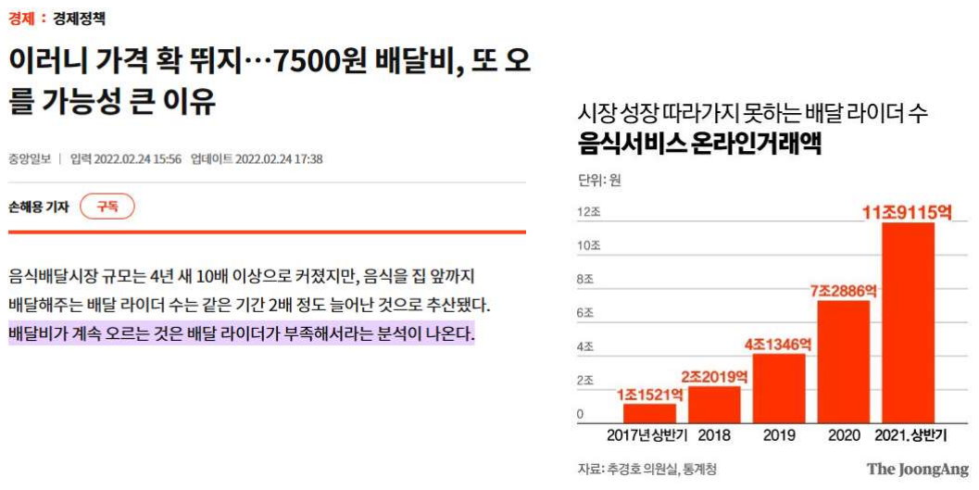
[picture p98: figure]

# 현재 야외용 배달로봇의 형태

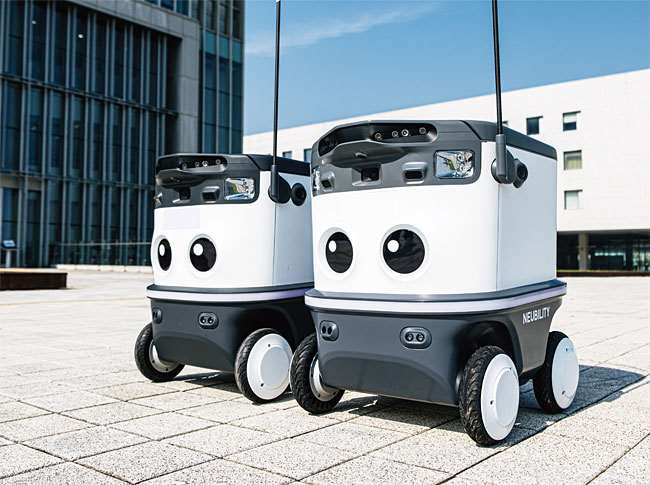
[picture p99: figure]
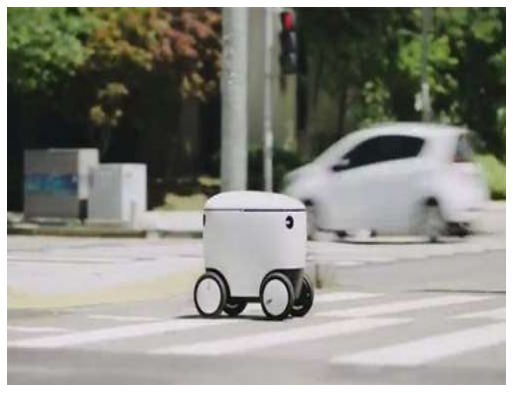
[picture p100: figure]

자율주행 배달 로봇 ‘뉴비’ | 배달의 민족 자율 주행 로봇 ‘딜리’ 목적: 험지 주파에 장애가 없는 동시에 흔들림을 최소화할 수 있는 음료배송로봇

기능:

### 1. 험지에 기계적으로 적응할 수 있는 구동계 2. 흔들림에 제어적으로 적응할 수 있는 스태빌레이터 3. 두 시스템을 연결하면서 상호 기능을 방해하지 않는 결합방식

구조:

### 1. 링크와 다중 구동륜을 이용한 라커-보기 메커니즘 2. IMU 자세정보를 피드백하여 세개의 모터를 PID 제어하는 짐벌 스태빌레이터 3. 자유회전축과 밸러스트를 이용한 오뚜기식 연결 메커니즘

# 개념설계

5

6

# Rocker-Bogie 설계

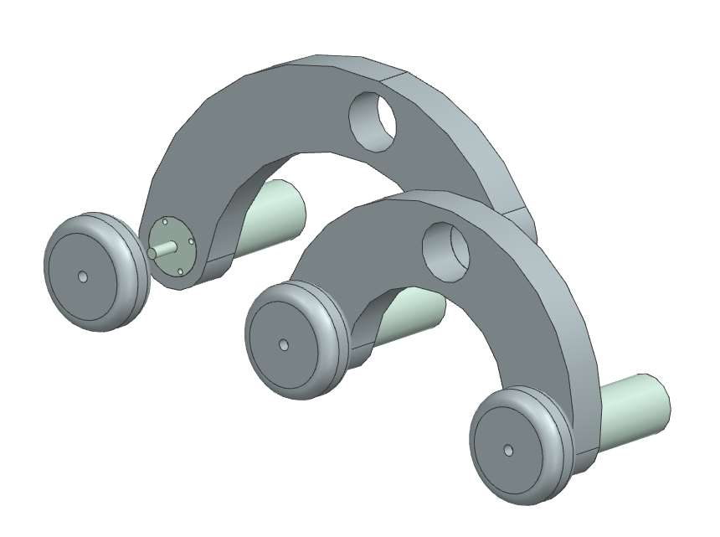
[picture p101: figure]
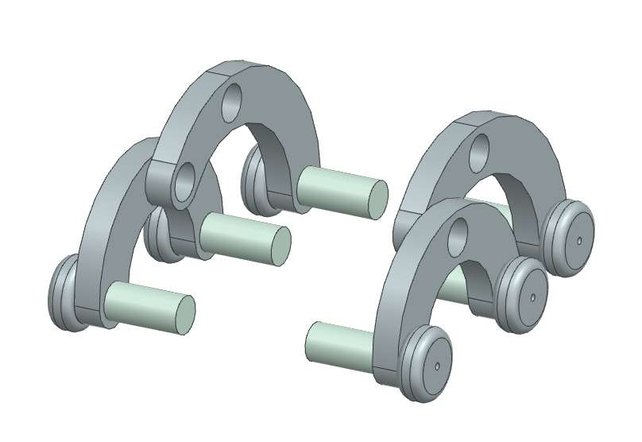
[picture p102: figure]

기초적인 라커보기 구조

# Rocker-Bogie와 stabilizer 결합

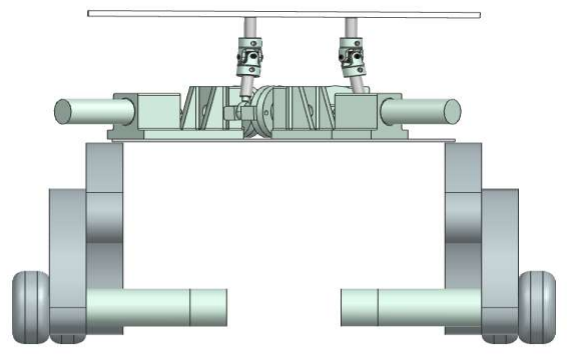
[picture p103: figure]

라커보기 구조 위에 그대로 올릴 시
-무게중심이 너무 높아지는 단점

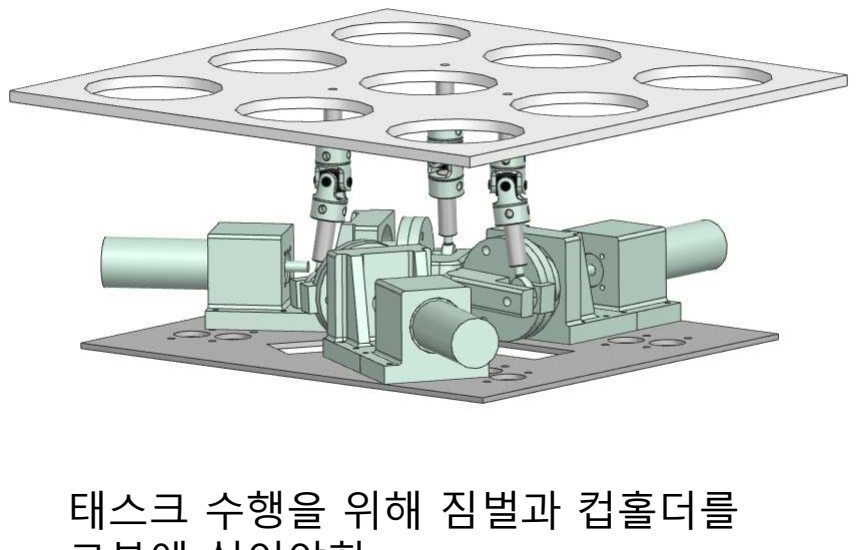
[picture p104: figure]
태스크 수행을 위해 짐벌과 컵홀더를

로봇에 실어야함

7

8

# Rocker-Bogie와 stabilizer 결합

## -라커보기 구조물의 높이를 낮출 시(A안-라커보기 구조물의 높이를 낮춤)

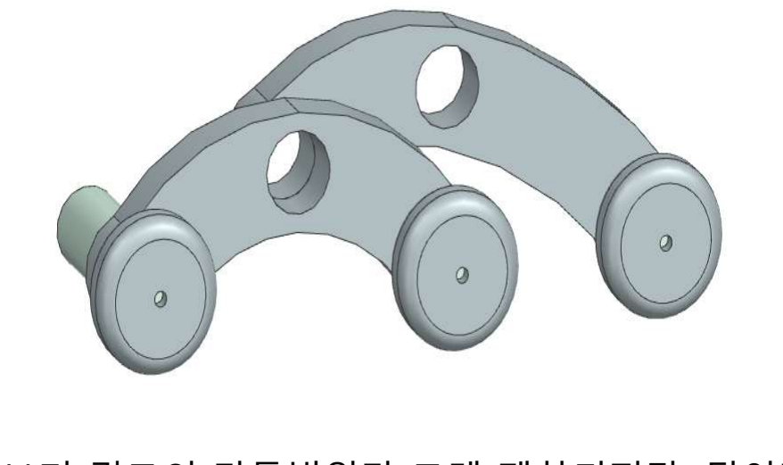
[picture p105: figure]
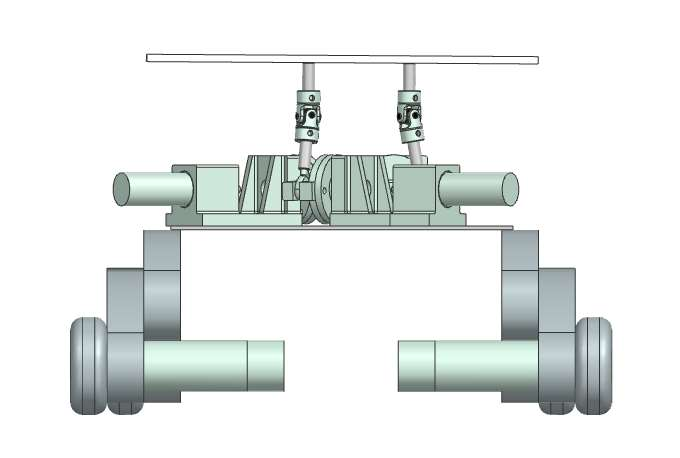
[picture p106: figure]

보기 링크의 가동범위가 크게 제한되지만, 턱이나 계단 등 극단적인 장애물을 배제한 단순 야외 노면 돌파는 가능할 것으로 보임

# Rocker-Bogie와 stabilizer 결합

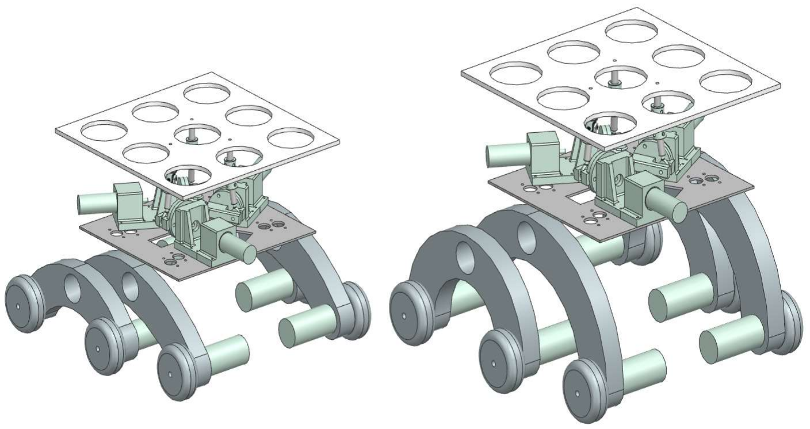
[picture p107: figure]

기본안과 A안의 비교- 두 설계 모두 중앙구조물의 무게중심이 회전축보다 높음. 라커의 가동을 포기하 고 라커 링크 쪽에 중앙구조물을 고정해야 함. 이 경 우 양쪽 라커를 모두 고정하면 보기 링크도 거동이 제약되어 험지주파 능력이 떨어짐.

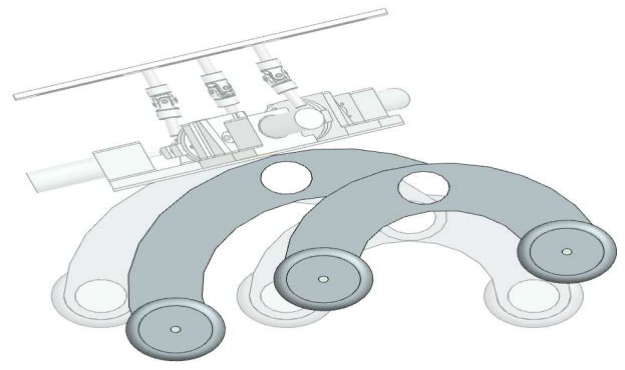
[picture p108: figure]

한쪽 라커 링크에만 고정-두 라커 링크가 개별가동할 수 있으므로 주파력은 확보되지만, 중앙구조물을 고정 한 쪽의 라커 링크가 움직일 경우 중앙구조물도 기울 어지므로 음료 운송에 큰 지장이 있음.

9

10

# Rocker-Bogie와 stabilizer 결합

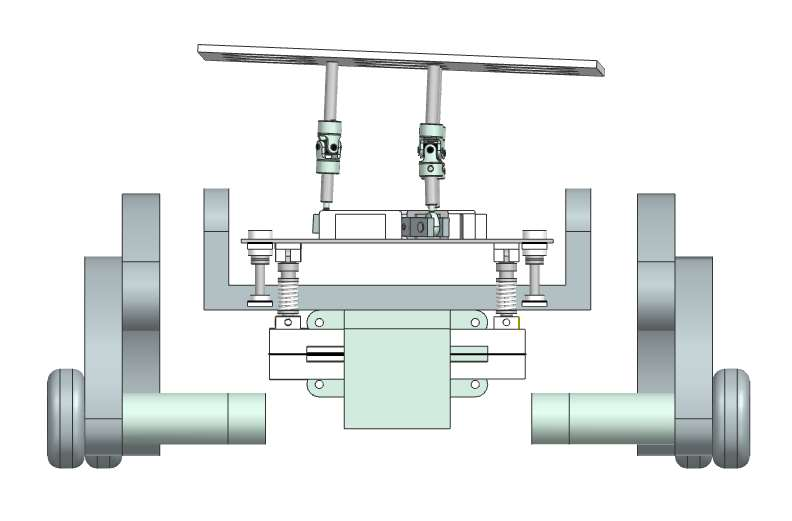
[picture p109: figure]

높은 라커보기 구조를 이용하되, 중앙구조물에
Swing 구조물을 추가해 중앙측의 무게중심을 회전 축보다 낮추는 방안 (B안)

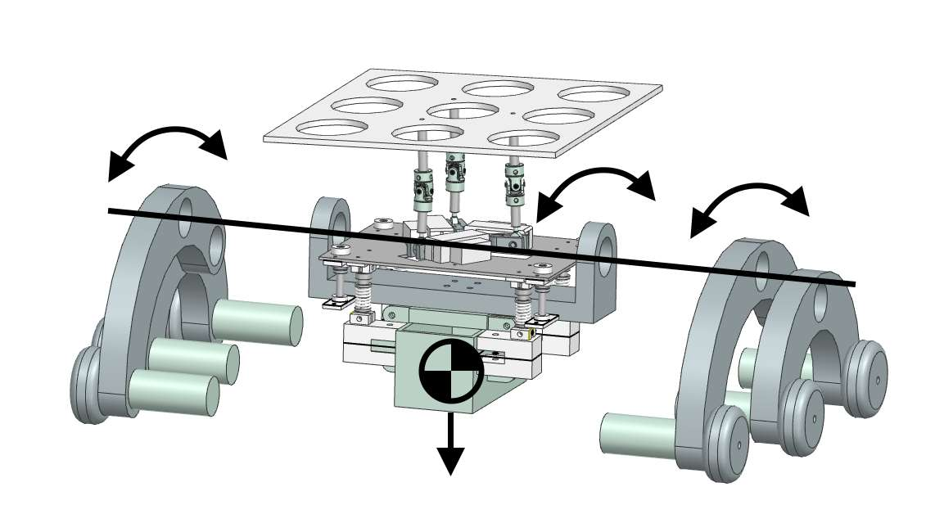
[picture p110: figure]

- AGV용 배터리를 중앙 구조물 하단에 밸러스 트를 겸하도록 위치시켜, 중앙구조물이 자유
회전축에 연결된 채 오뚜기처럼 균형을 잡을
수 있음
- 양쪽 라커 링크가 모두 자유롭게 동작할 수
있어 험지 돌파 능력도 제대로 확보

11
