yeoungseon/capstone/2023/발표자료/주간발표-5(2023.3.18. 1차 심사 대비).pdf

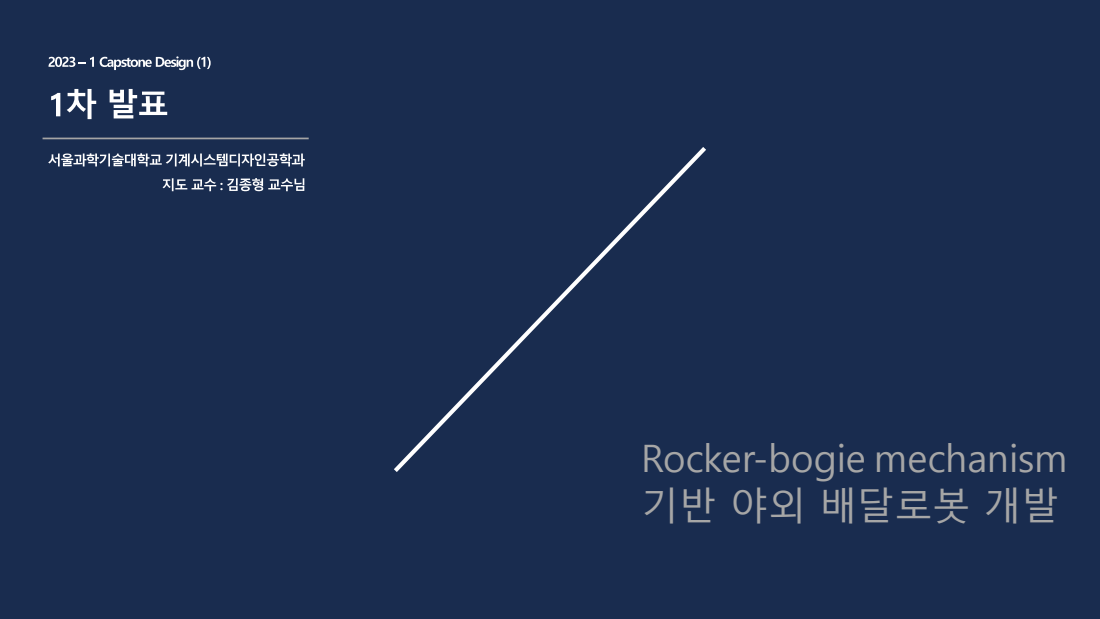
[picture p121: page 1]

Rocker-bogie mechanism
기반 야외 배달로봇 개발

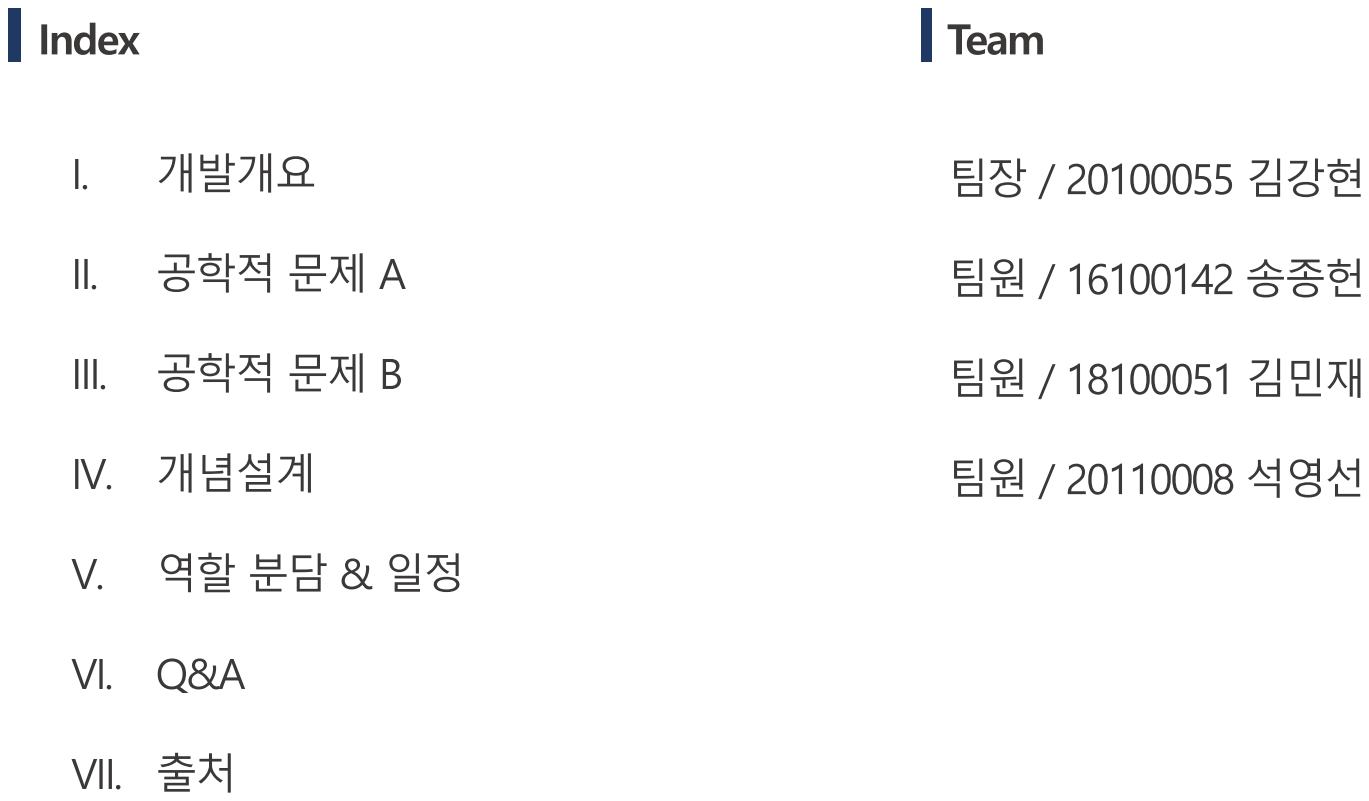
[picture p122: page 2]

### 개발 개요

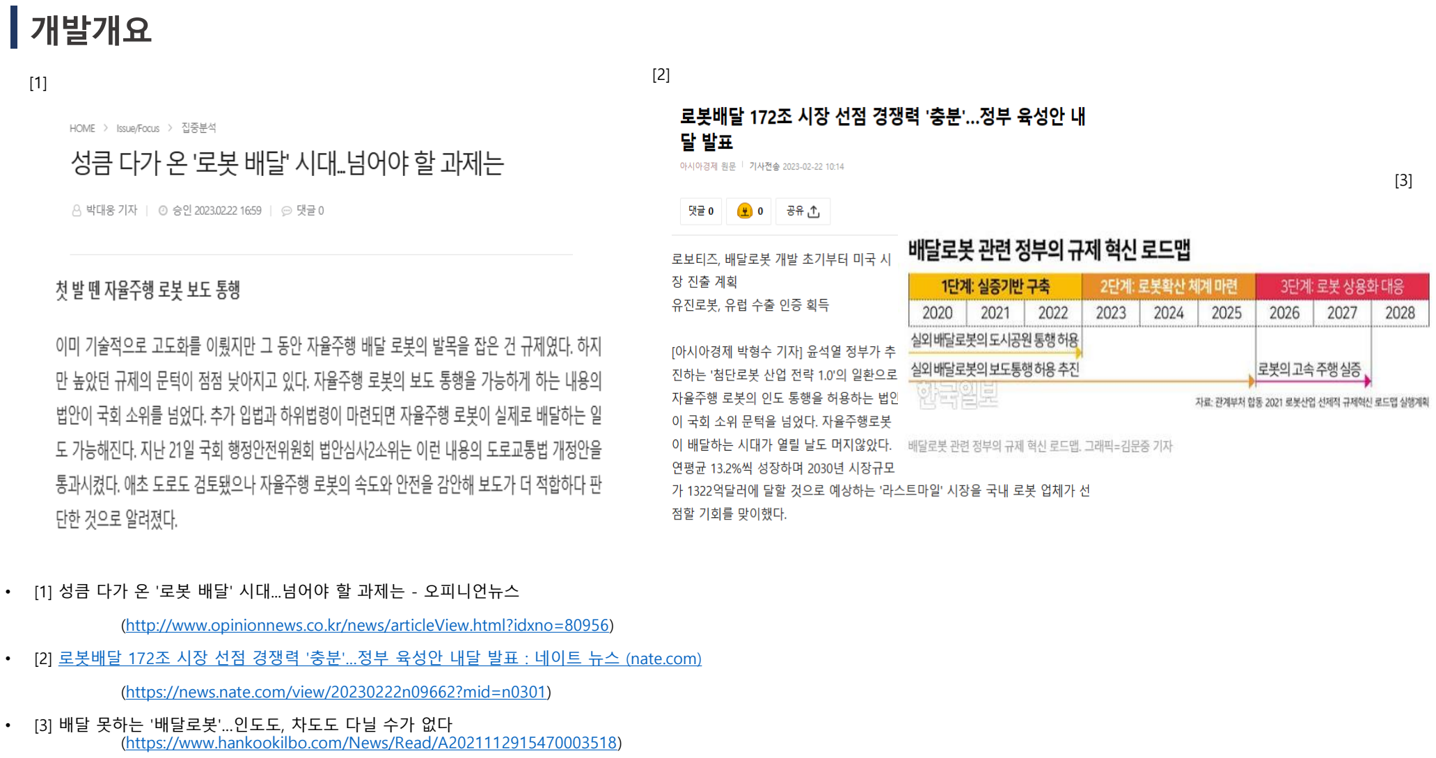
[picture p123: page 4]

- [1] 성큼 다가 온 '로봇 배달' 시대...넘어야 할 과제는 - 오피니언뉴스

(http://www.opinionnews.co.kr/news/articleView.html?idxno=80956)

- [2] 로봇배달 172조 시장 선점 경쟁력 '충분'…정부 육성안 내달 발표 : 네이트 뉴스 (nate.com) (https://news.nate.com/view/20230222n09662?mid=n0301)

(https://news.nate.com/view/20230222n09662?mid=n0301)

- [3] 배달 못하는 '배달로봇'…인도도, 차도도 다닐 수가 없다 (https://www.hankookilbo.com/News/Read/A2021112915470003518)

[1]

[2]

[3]

[2]

[3]

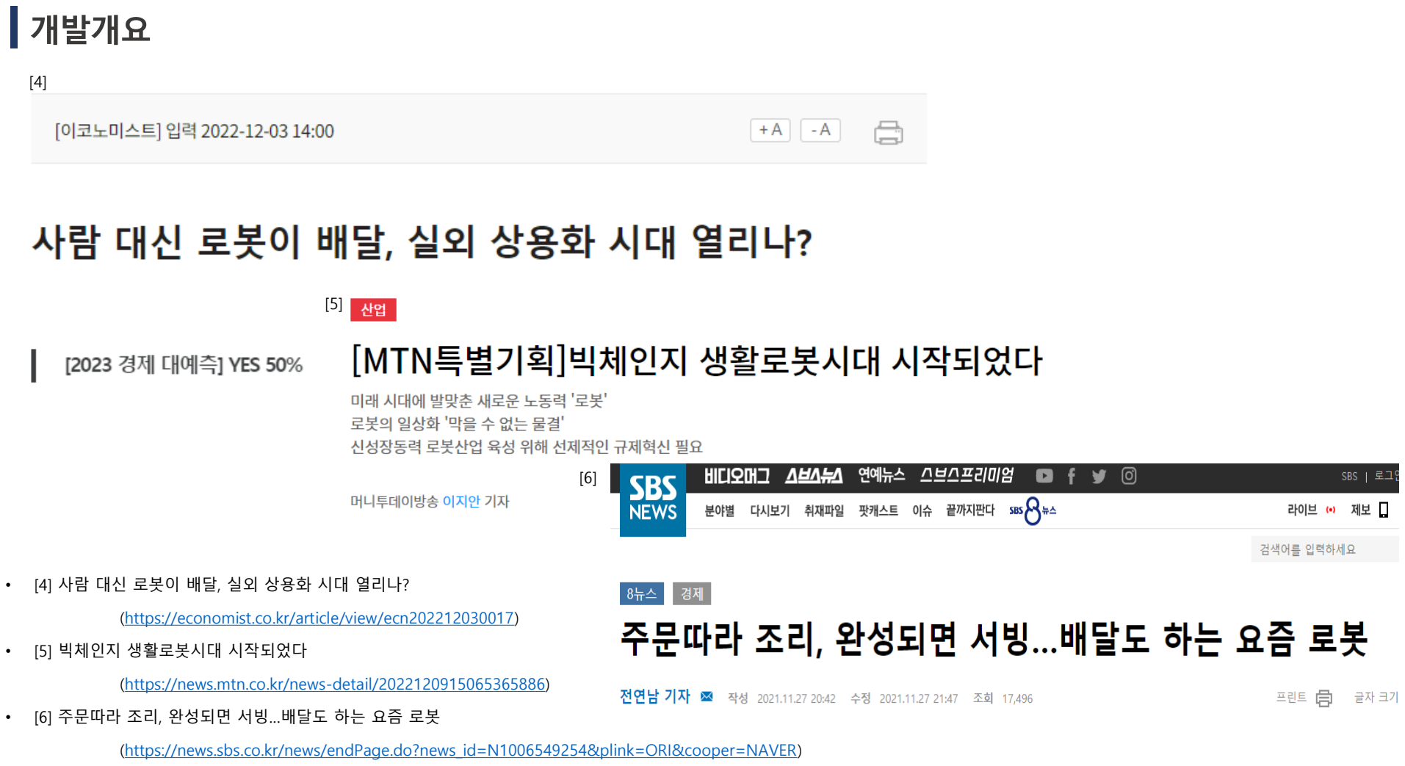
[picture p124: page 5]

- [4] 사람 대신 로봇이 배달, 실외 상용화 시대 열리나?

(https://economist.co.kr/article/view/ecn202212030017)

- [5] 빅체인지 생활로봇시대 시작되었다

(https://news.mtn.co.kr/news-detail/2022120915065365886)

- [6] 주문따라 조리, 완성되면 서빙…배달도 하는 요즘 로봇

(https://news.sbs.co.kr/news/endPage.do?news_id=N1006549254&plink=ORI&cooper=NAVER)

[4]

[5]

[6]

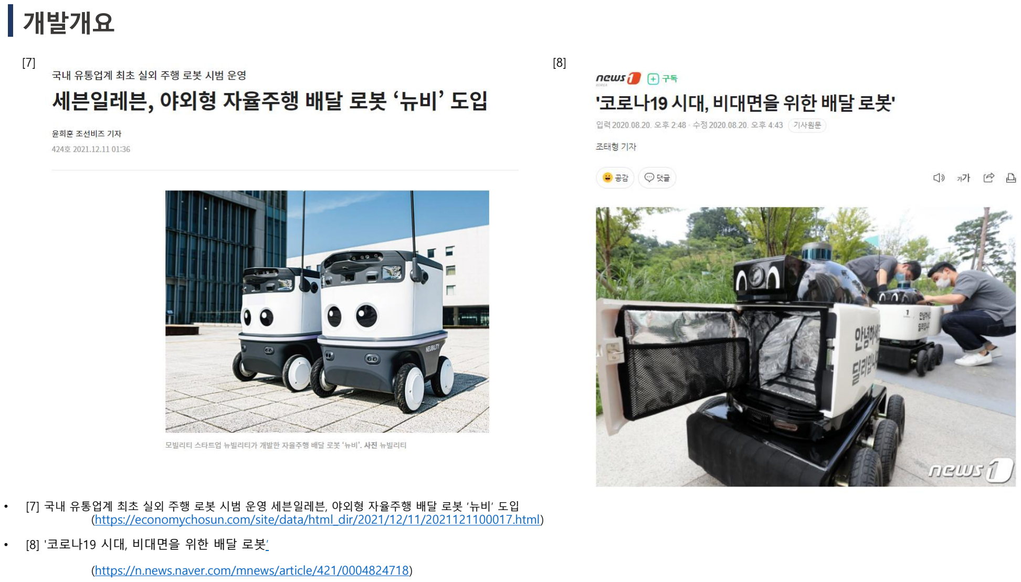
[picture p125: page 6]

- [7] 국내 유통업계 최초 실외 주행 로봇 시범 운영 세븐일레븐, 야외형 자율주행 배달 로봇 ‘뉴비’ 도입 (https://economychosun.com/site/data/html_dir/2021/12/11/2021121100017.html)
- [8] '코로나19 시대, 비대면을 위한 배달 로봇’ (https://n.news.naver.com/mnews/article/421/0004824718)

(https://n.news.naver.com/mnews/article/421/0004824718)

[7] [8]

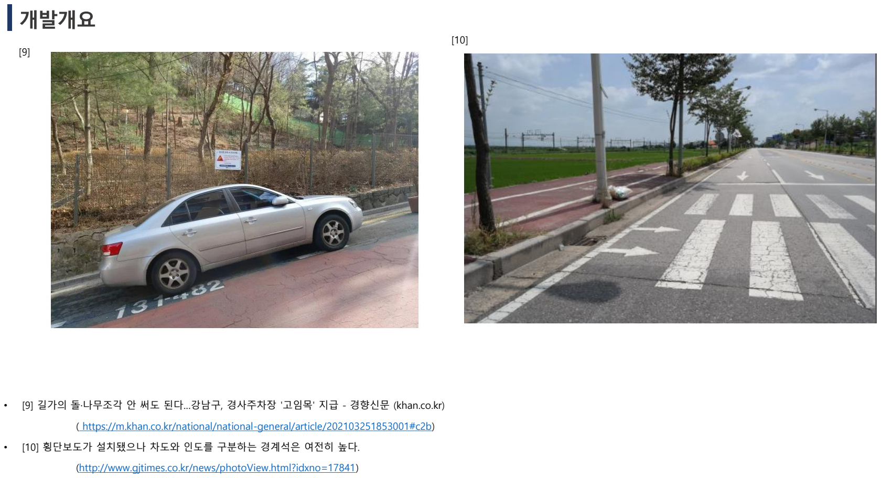
[picture p126: page 7]

- [9] 길가의 돌·나무조각 안 써도 된다…강남구, 경사주차장 '고임목' 지급 - 경향신문 (khan.co.kr)

( https://m.khan.co.kr/national/national-general/article/202103251853001#c2b)

- [10] 횡단보도가 설치됐으나 차도와 인도를 구분하는 경계석은 여전히 높다.

(http://www.gjtimes.co.kr/news/photoView.html?idxno=17841)

[9]

[10]

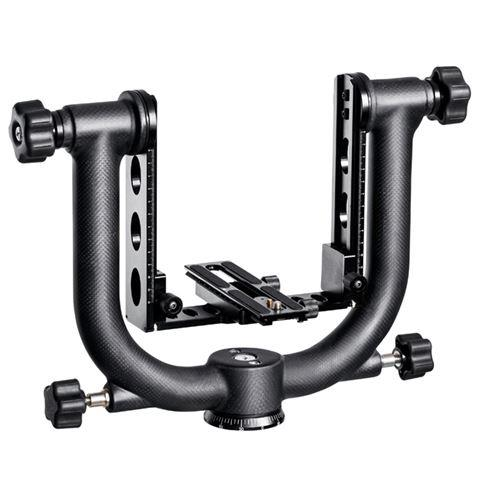
[picture p127: figure]
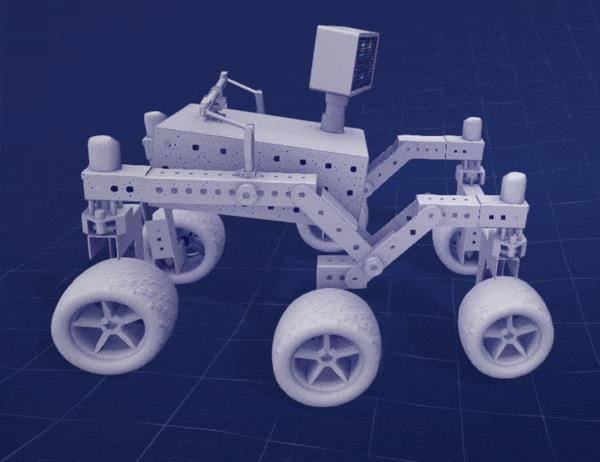
[picture p128: figure]

[11]

- [11] Deploying on Mars: NASA-JPL Open Source Rover

(https://www.freedomrobotics.com/blog/building-the-nasa-jpl-open-source-rover)

- [12] Sevenoak Carbon Gimbal Swing Panorama Head SK-GH10, 178,33 €

(https://www.mediaresort.de/Sevenoak-Carbon-Gimbal-Swing-Panorama-Head-SK-GH10)

[12]

- 실내 테스트
- A-경사로 극복 → B-턱 극복 → C-장애물 회피
- 전체 과정에서 경로 탐색, 음료의 안정성 유지를 지속 수행
- 이동경로상에서 SLAM에 필요한 라이다 데이터와 CCTV 이미지 획득에는 문제가 없다고 가정
- 횡단경사는 무시할 수 있는 수준이라고 가정

### 공학적 문제 A

최대 등판각 대응 링크 최적화

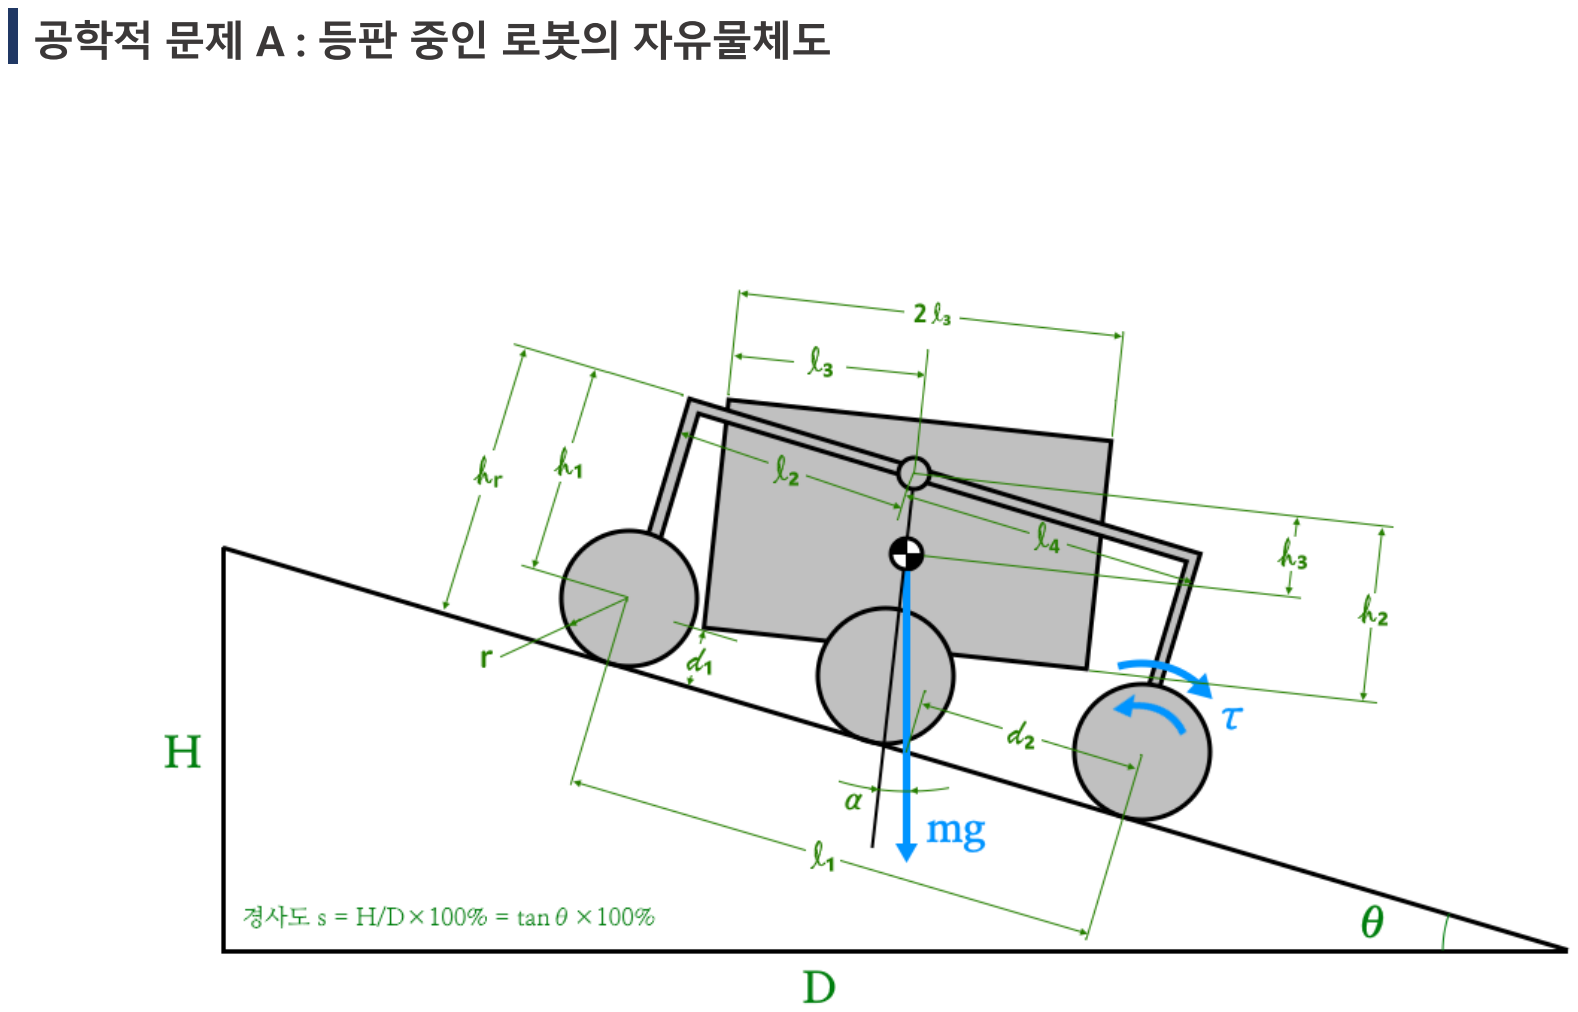
[picture p129: page 11]

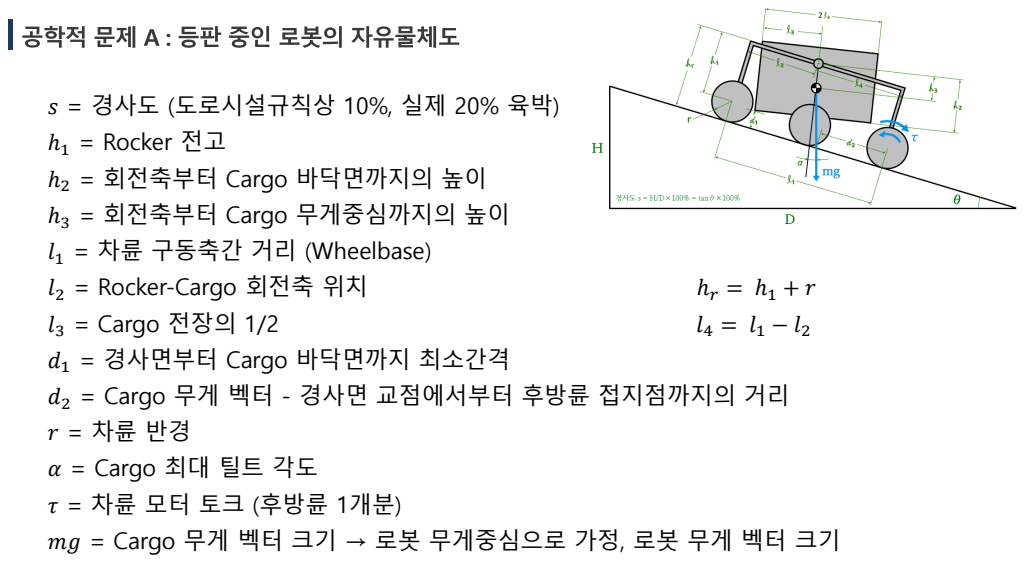
[picture p130: page 12]
l2 = Rocker-Cargo 회전축 위치; l3 = Cargo 전장의 1/2

s = 경사도 (도로시설규칙상 10%, 실제 20% 육박)
ℎ1 = Rocker 전고
ℎ2 = 회전축부터 Cargo 바닥면까지의 높이
ℎ3 = 회전축부터 Cargo 무게중심까지의 높이
l1 = 차륜 구동축간 거리 (Wheelbase)
d1 = 경사면부터 Cargo 바닥면까지 최소간격
d2 = Cargo 무게 벡터 - 경사면 교점에서부터 후방륜 접지점까지의 거리
α = Cargo 최대 틸트 각도
τ = 차륜 모터 토크 (후방륜 1개분)
mg = Cargo 무게 벡터 크기 → 로봇 무게중심으로 가정, 로봇 무게 벡터 크기

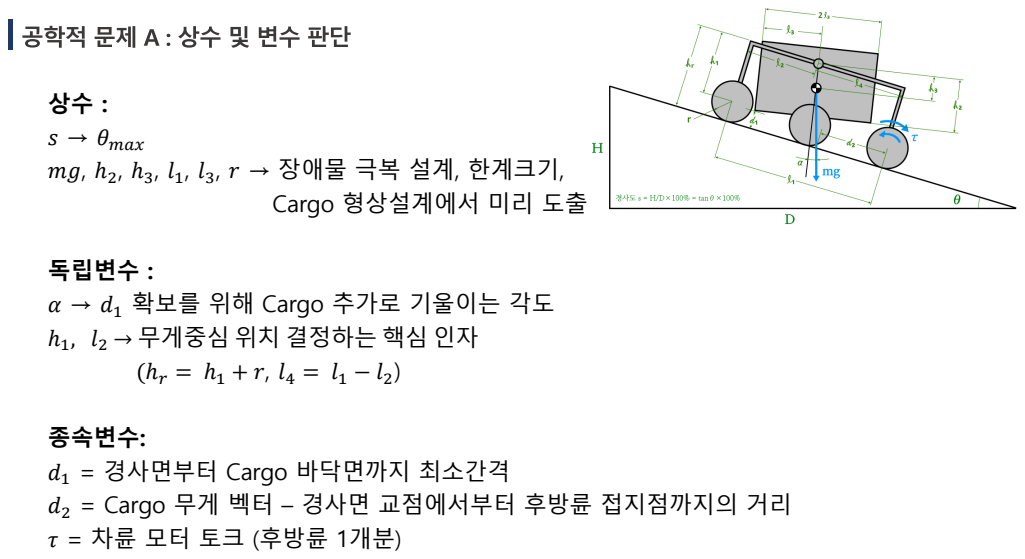
[picture p131: page 13]

s → θmax
mg, ℎ2, ℎ3, l1, l3, r → 장애물 극복 설계, 한계크기,

Cargo 형상설계에서 미리 도출

독립변수 :
α → d1 확보를 위해 Cargo 추가로 기울이는 각도
ℎ1, l2 → 무게중심 위치 결정하는 핵심 인자

종속변수:
d1 = 경사면부터 Cargo 바닥면까지 최소간격
d2 = Cargo 무게 벡터 – 경사면 교점에서부터 후방륜 접지점까지의 거리
τ = 차륜 모터 토크 (후방륜 1개분)

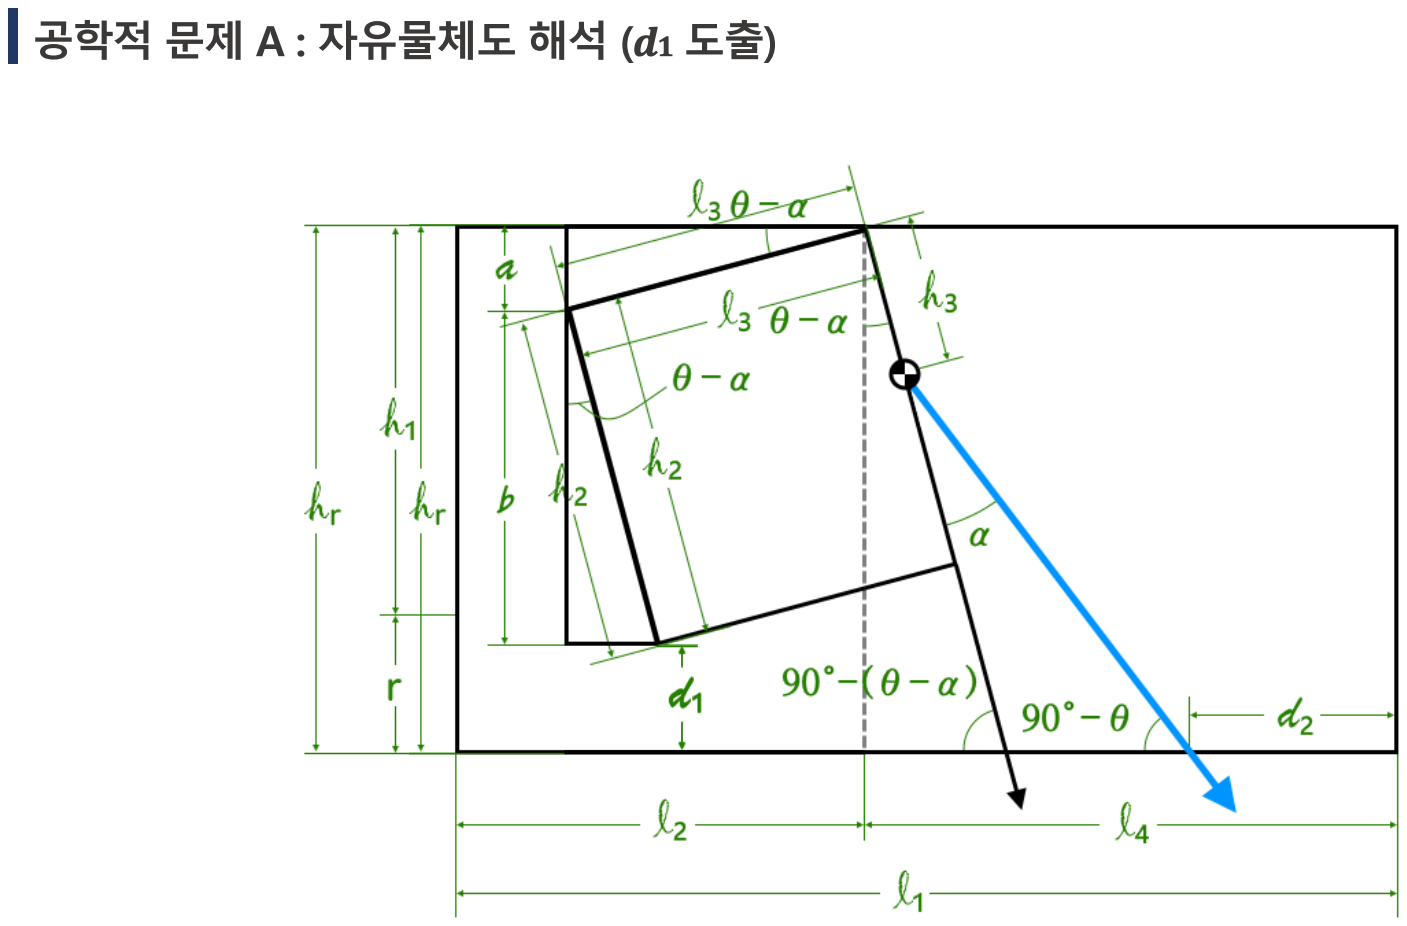
[picture p132: page 14]

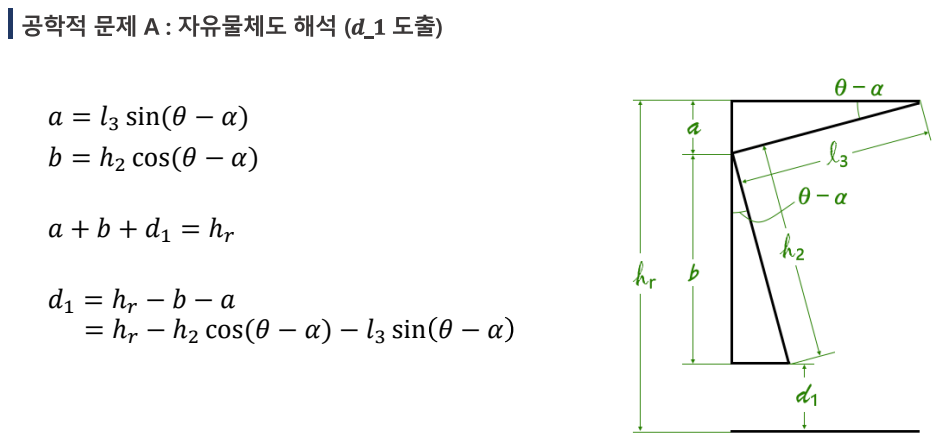
[picture p133: page 15]
a = l3 sin(θ − α) b = ℎ2 cos(θ − α)

= ℎr − ℎ2 cos(θ − α) − l3 sin θ − α

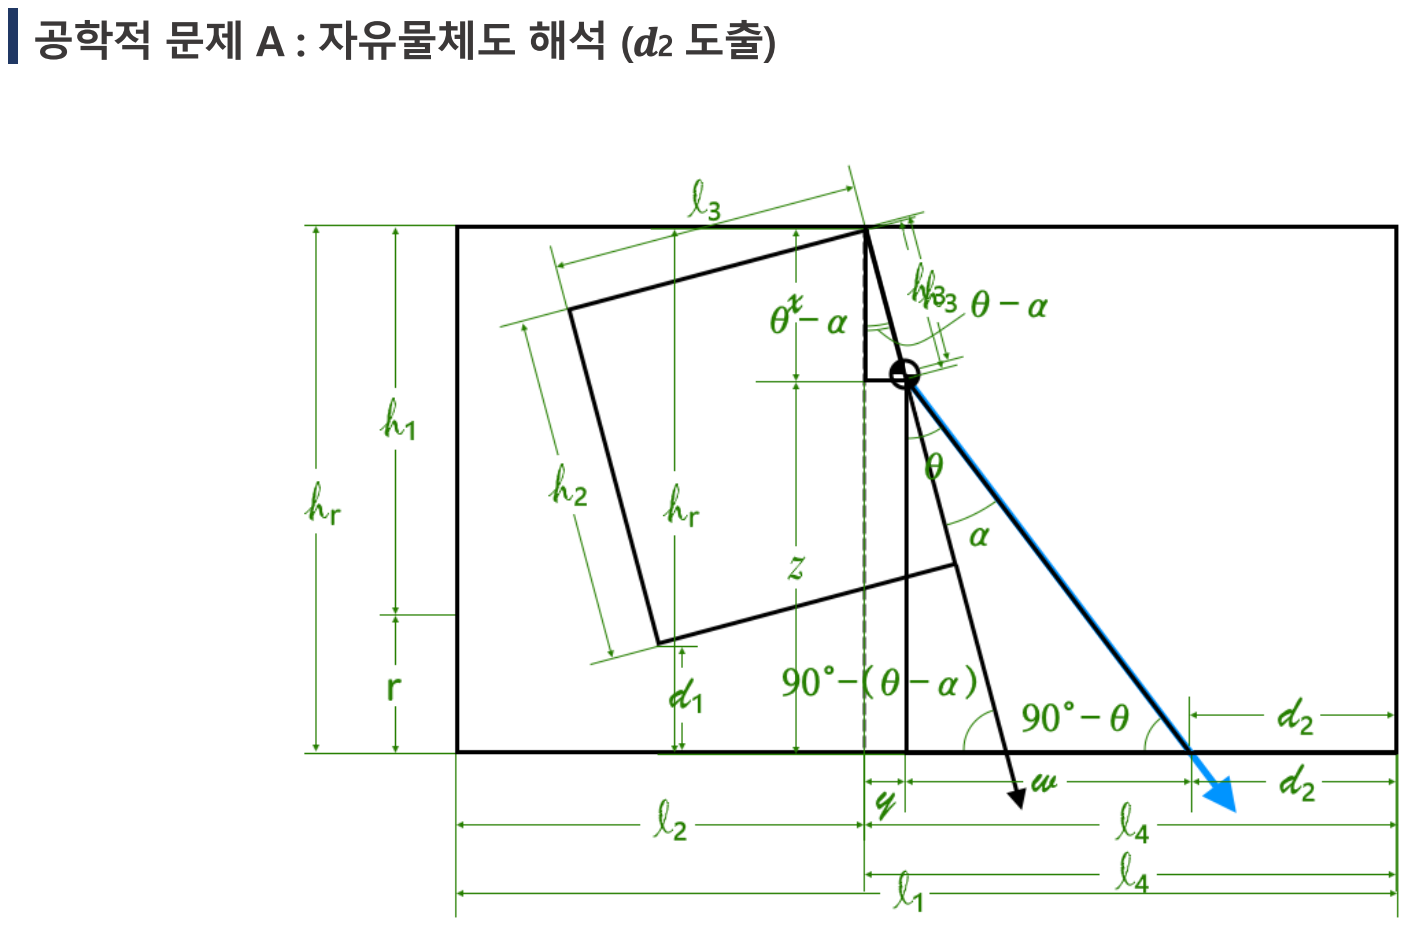
[picture p134: page 16]

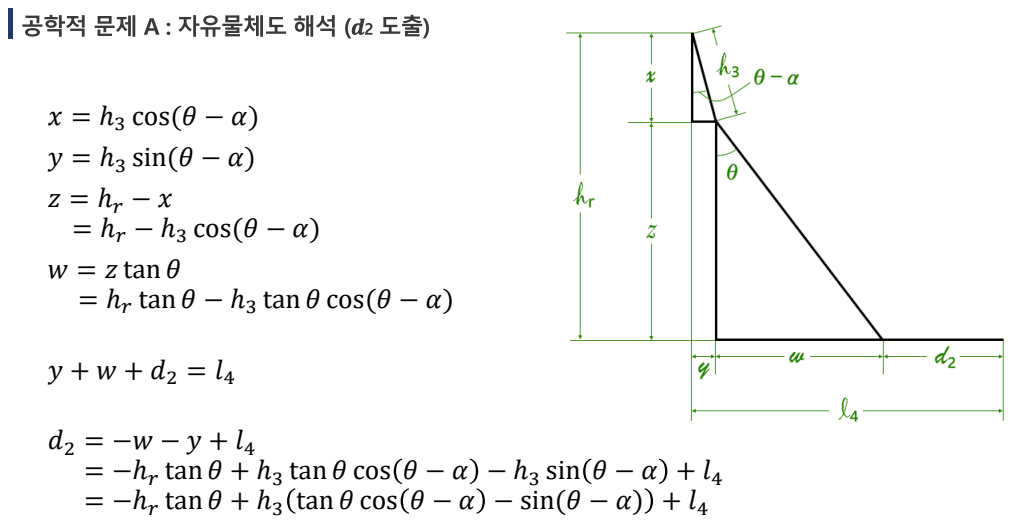
[picture p135: page 17]
x = ℎ3 cos(θ − α) y = ℎ3 sin(θ − α) z = ℎr − x = ℎr − ℎ3 cos(θ − α) w = z tan θ = ℎr

tan θ − ℎ3 tan θ cos(θ − α)

tan θ + ℎ3 tan θ cos θ − α − ℎ3 sin θ − α + l4
tan θ + ℎ3 tan θ cos θ − α − sin(θ − α) + l4

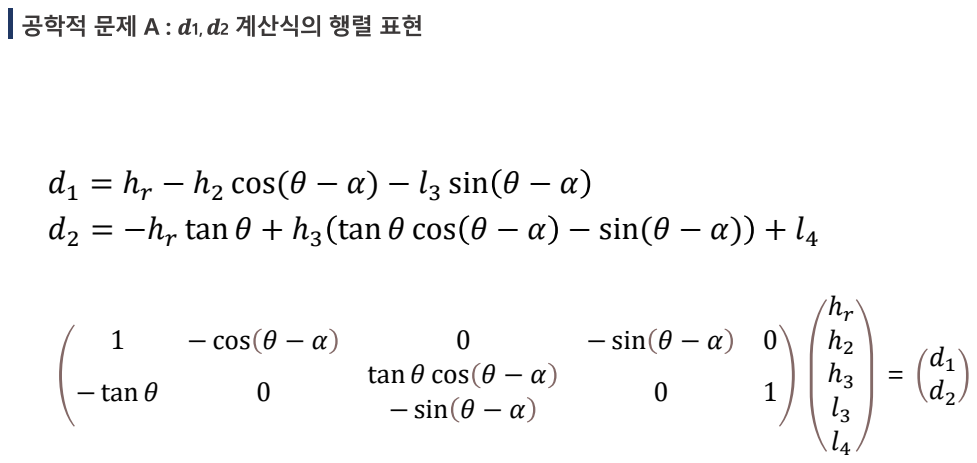
[picture p136: page 18]
− cos θ − α; − sin θ − α; − tan θ; tan θ cos θ − α − sin θ − α

d1 = ℎr − ℎ2 cos(θ − α) − l3 sin θ − α

tan θ + ℎ3 tan θ cos θ − α − sin(θ − α) + l4

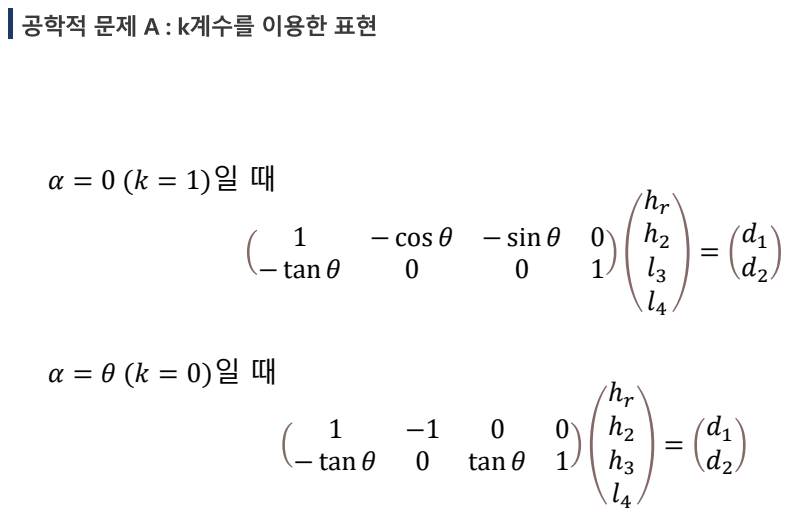
[picture p137: page 19]
− cos; − sin; − tan; tan

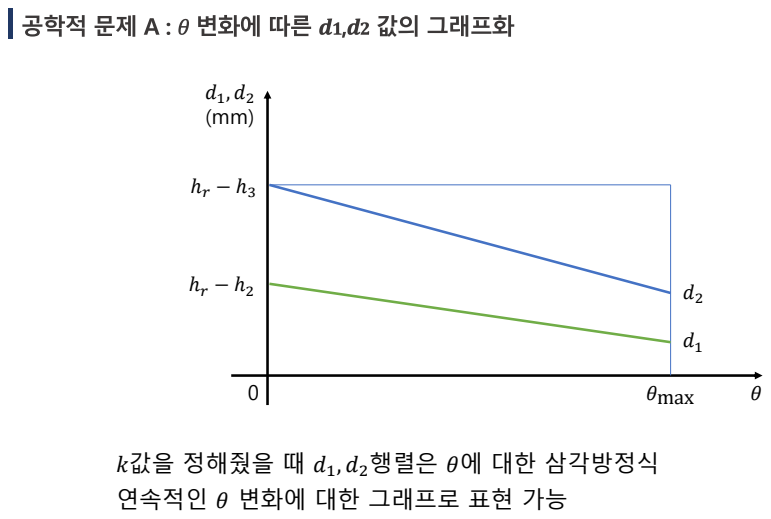
[picture p138: page 20]
θmax

k값을 정해줬을 때 d1, d2행렬은 θ에 대한 삼각방정식
연속적인 θ 변화에 대한 그래프로 표현 가능

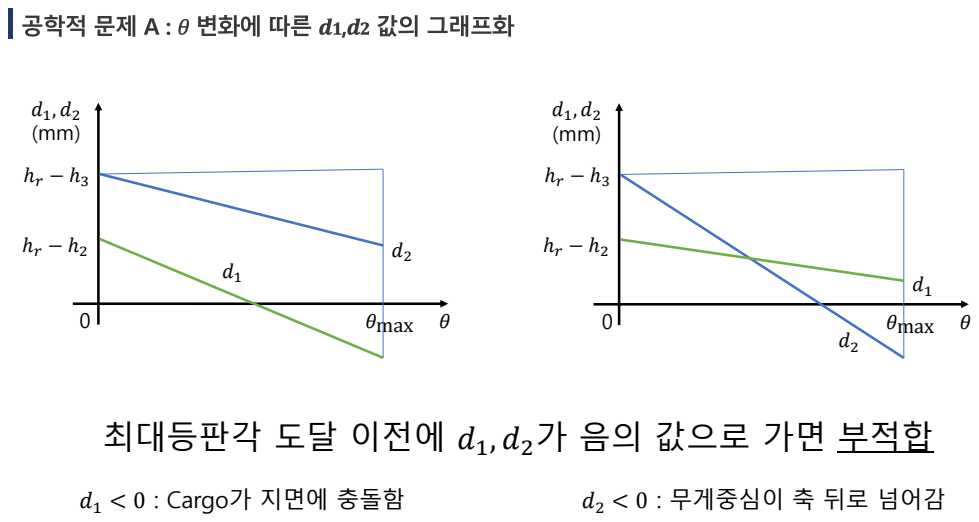
[picture p139: page 21]
d1 < 0 : Cargo가 지면에 충돌함; d2 < 0 : 무게중심이 축 뒤로 넘어감; θmax

최대등판각 도달 이전에 d1, d2가 음의 값으로 가면 부적합

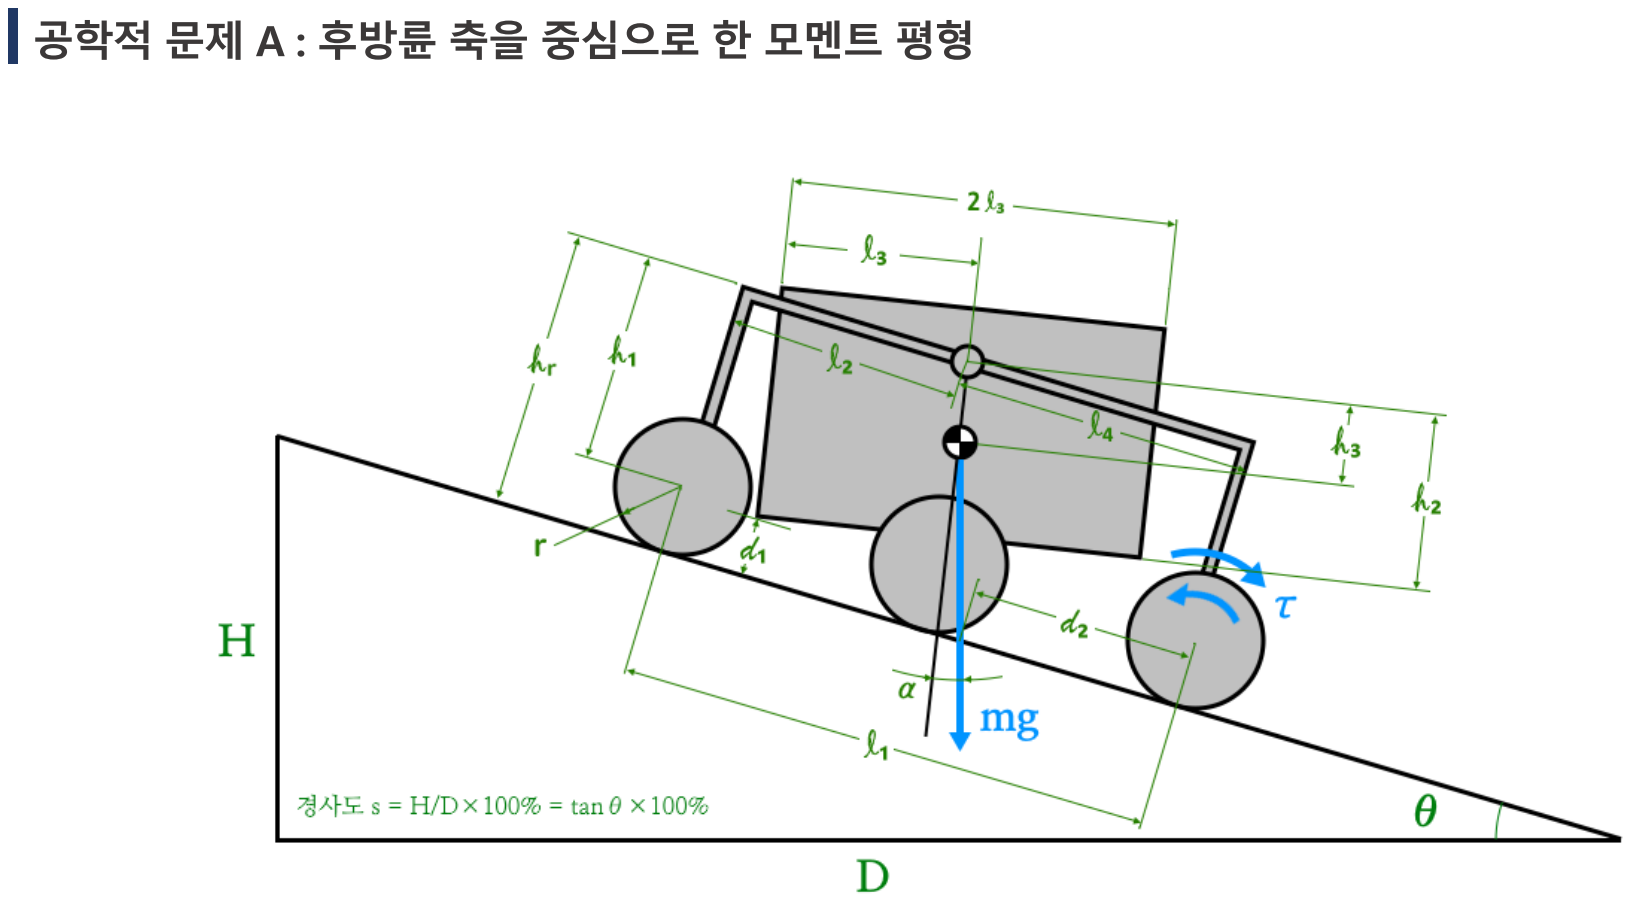
[picture p140: page 22]

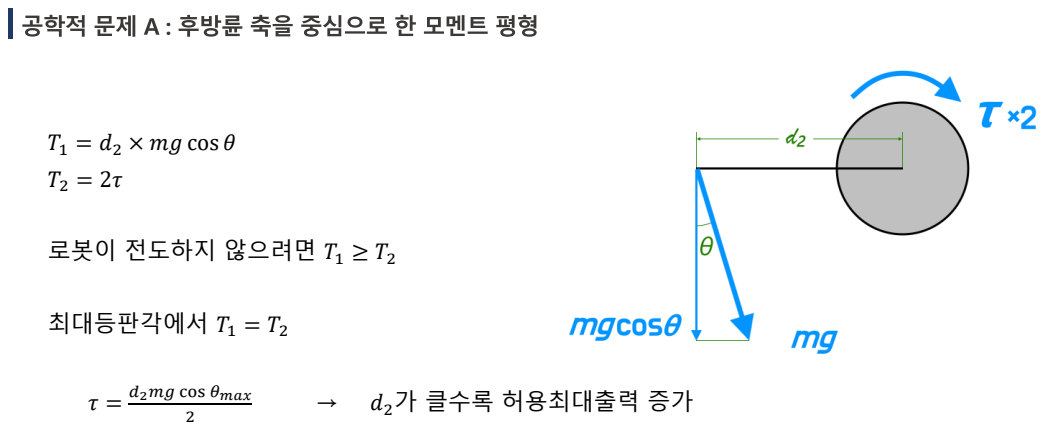
[picture p141: page 23]
T1 = d2 × mg cos θ; 최대등판각에서 T1 = T2; d2mg cos θmax; d2가 클수록 허용최대출력 증가

로봇이 전도하지 않으려면 T1 ≥ T2

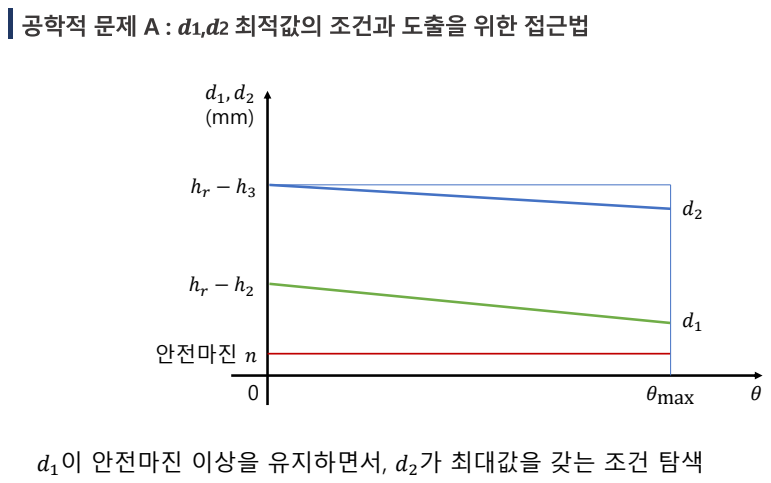
[picture p142: page 24]
θmax; 안전마진 n

d1이 안전마진 이상을 유지하면서, d2가 최대값을 갖는 조건 탐색

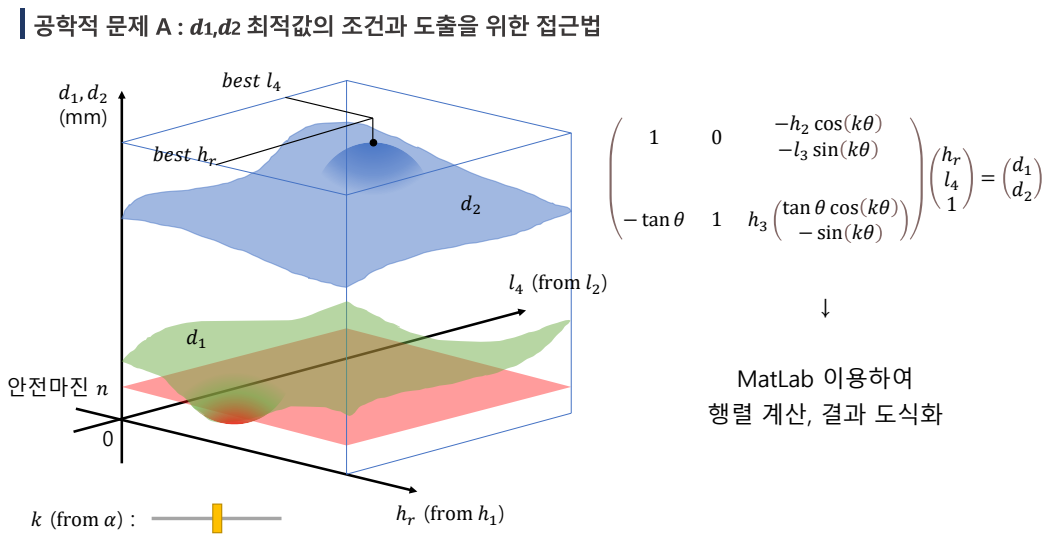
[picture p143: page 25]
안전마진 n; (from ℎ1); l4 (from l2); k (from α) :; best l4; best ℎr; −ℎ2 cos kθ −l3 sin kθ; − tan θ

tan θ cos kθ
− sin kθ

MatLab 이용하여
행렬 계산, 결과 도식화

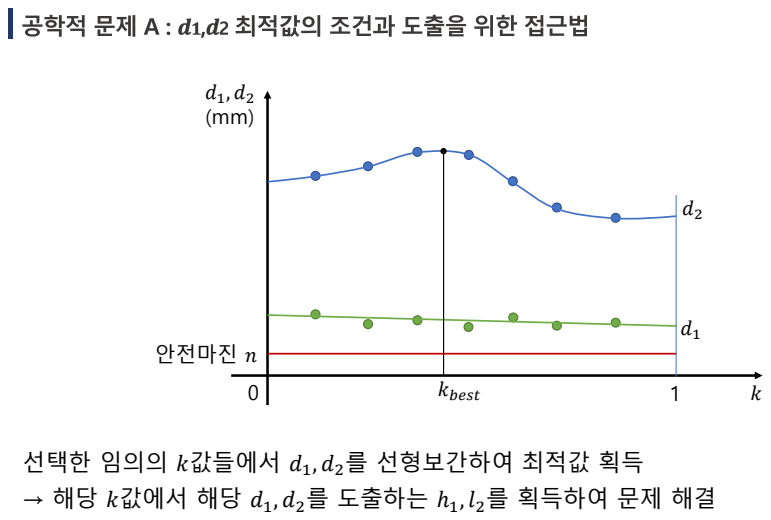
[picture p144: page 26]
안전마진 n; kbest

선택한 임의의 k값들에서 d1, d2를 선형보간하여 최적값 획득
→ 해당 k값에서 해당 d1, d2를 도출하는 ℎ1, l2를 획득하여 문제 해결

### 공학적 문제 B

턱 극복 대응 링크 및 바퀴 크기 최적화

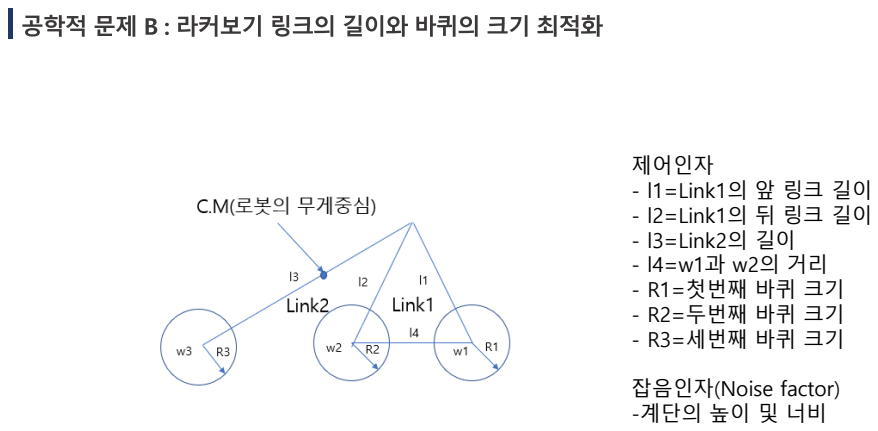
[picture p145: page 28]

제어인자
- l1=Link1의 앞 링크 길이
- l2=Link1의 뒤 링크 길이
- l3=Link2의 길이
- R1=첫번째 바퀴 크기
- R2=두번째 바퀴 크기
- R3=세번째 바퀴 크기

잡음인자(Noise factor)
-계단의 높이 및 너비

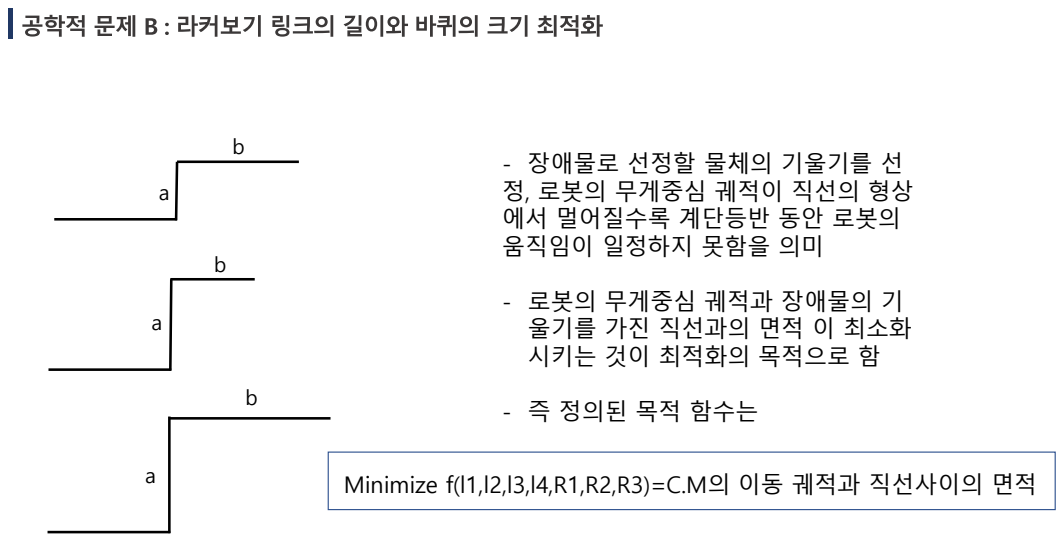
[picture p146: page 29]

- 장애물로 선정할 물체의 기울기를 선
정, 로봇의 무게중심 궤적이 직선의 형상
에서 멀어질수록 계단등반 동안 로봇의
움직임이 일정하지 못함을 의미

- 로봇의 무게중심 궤적과 장애물의 기
울기를 가진 직선과의 면적 이 최소화
시키는 것이 최적화의 목적으로 함

- 즉 정의된 목적 함수는

Minimize f(l1,l2,l3,l4,R1,R2,R3)=C.M의 이동 궤적과 직선사이의 면적


- 최적화 문제의 제한조건 정의

1. 바퀴의 크기는 일반적인 바퀴 크기들
을 고려해서 최저값을 가지고, 가장
가파른 계단에 대해서 안정 적으로
바퀴가 머무를 수 있도록 최대값을
가지도록 함
2. 하나의 링크로 연결된 W1 과 W2 는
서로 겹치지 않으며, 동시에 계단의
디딤면(계단의 수평면)에 함께 떨어지
지 않도록 함
4. 각 링크의 길이도 최소 값과 최대값

- 시중에서 판매되는 최소 바퀴크기 ≤ R1,R2,R3 ≤ 가장
가파른 계단에 대해서 안정적으로 바퀴가 머무를 수 있
는 최대값
- R1, R2, R3≤l1, l2, l3, l4≤l3 or l1의 최대 길이값 설정

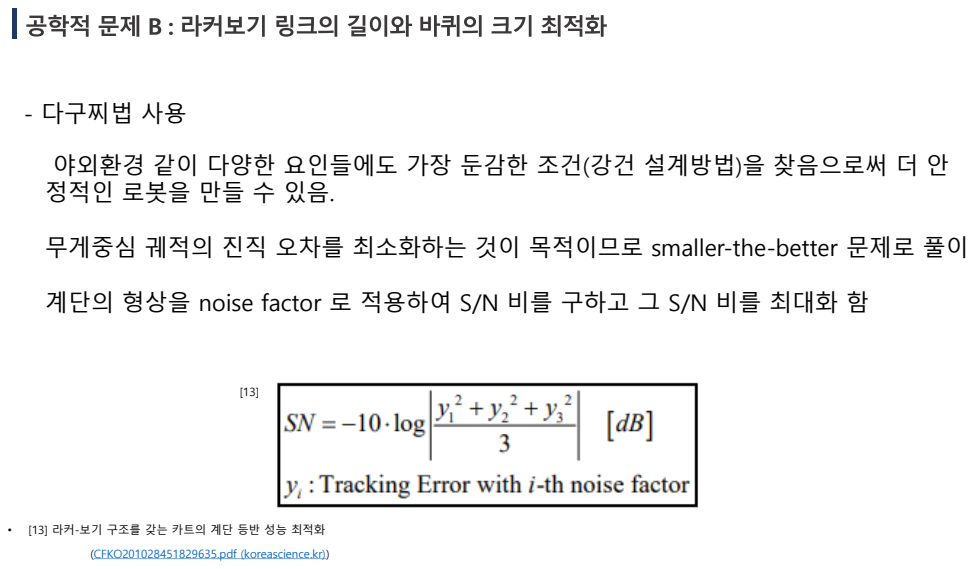
[picture p147: page 31]
- 다구찌법 사용

야외환경 같이 다양한 요인들에도 가장 둔감한 조건(강건 설계방법)을 찾음으로써 더 안
정적인 로봇을 만들 수 있음.

무게중심 궤적의 진직 오차를 최소화하는 것이 목적이므로 smaller-the-better 문제로 풀이

계단의 형상을 noise factor 로 적용하여 S/N 비를 구하고 그 S/N 비를 최대화 함

• [13] 라커-보기 구조를 갖는 카트의 계단 등반 성능 최적화

(CFKO201028451829635.pdf (koreascience.kr)) (https://koreascience.kr/article/CFKO201028451829635.pdf)

### 개념설계

- 시나리오 환경에서 험지 주파에 장애가 없는 동시에 흔들림을 최소화할 수 있는 음료 배달로봇
- 음식이 아닌 음료배달을 목적으로 선정한 이유 : 눈으로 확인하기 쉽고 스테빌라이저 효과를 가장 잘 이용할수 있을것이라고 예상 됨

- 험지에 기계적으로 적응할 수 있는 구동계
- 흔들림에 제어적으로 적응할 수 있는 스테빌라이저
- 두 시스템을 연결하면서 상호 기능을 방해하지 않는 결합
- 시속 7km의 속력을 낼 수 있으며 15cm의 장애물 극복가능
- 극복이 불가능한 장애물에 대해 새 경로 설정가능

- 장애물의 크기: 인도와 차도 사이의 턱 높이가 15cm 이므로 극복 가능한 장애물 의 최대 높이를 15cm로 선정 ->15cm 이상의 장애물의 경우 극복 불가능한 장애 물로 인식하여 새 경로 탐색
- 로봇의 속도: 사고발생시 보행자의 안전을 위해 보행자와 비슷한 속력인 7km/h 로 선정 -> 장애물 극복시 너무 큰 충격이 발생하면 속력을 줄이는 방향으로 조정
- 제한조건: 로커-보기 구조가 계단과 같이 연속으로 이루어진 장애물, 15cm 이상 의 장애물에 취약하므로 극복 불가능한 장애물로 인식
- 극복 여부 판단 방법: 레이더 맵핑 센서의 높이 조절을 통해 15cm 미만의 장애물 은 극복 가능 장애물로 판단 -> 로봇의 이동에 따라 레이더 맵핑 센서의 측정 각 도가 변할 경우 swing 부분에 센서를 결합시켜 일정한 각도를 유지

- 링크와 다중 구동륜을 이용한 Rocker-Bogie 메커니즘을 사용

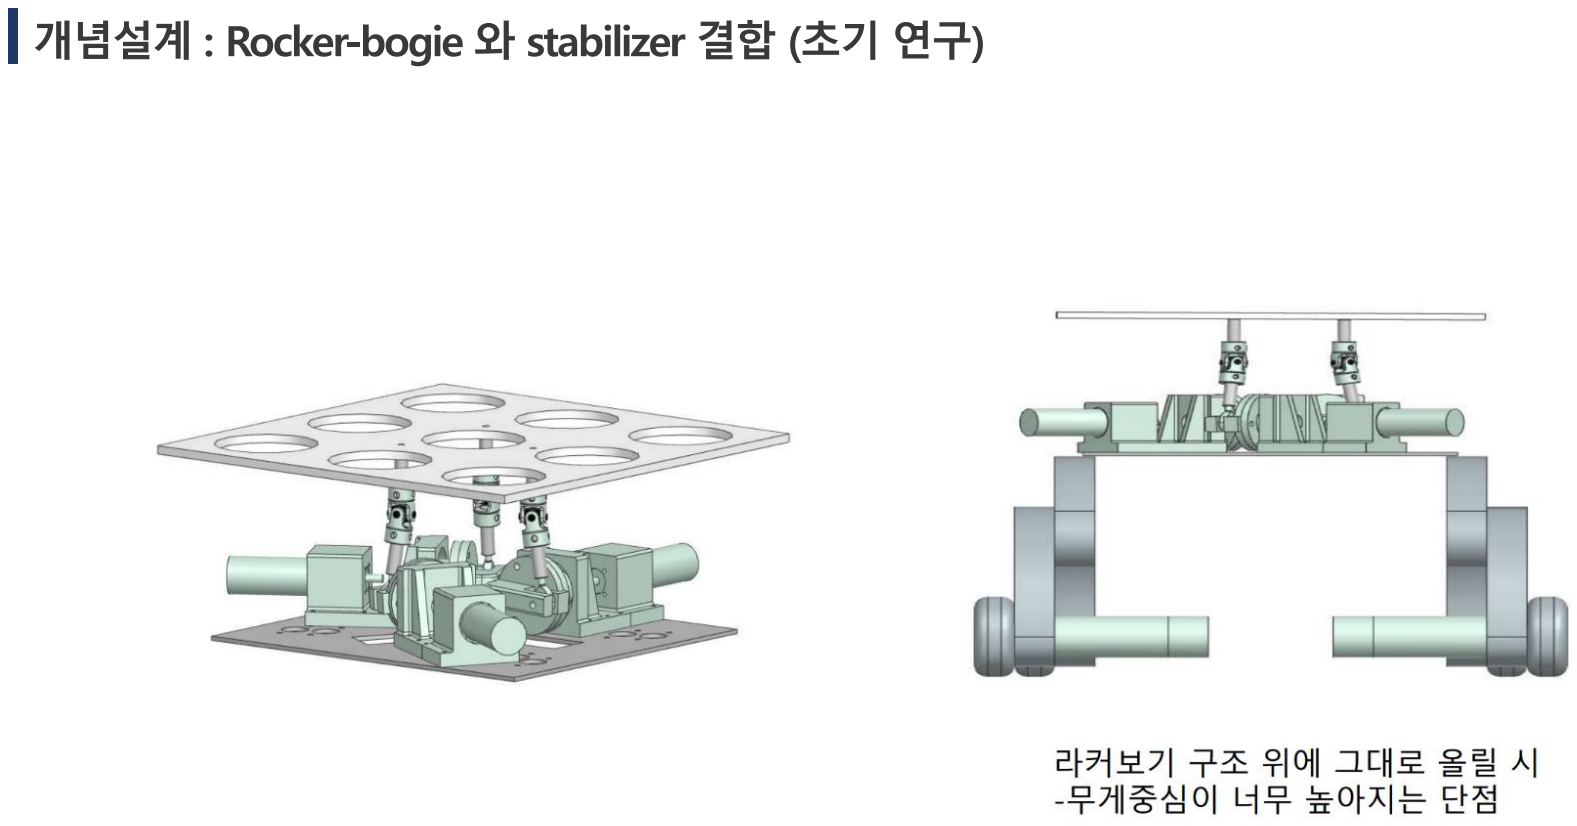
[picture p148: page 37]

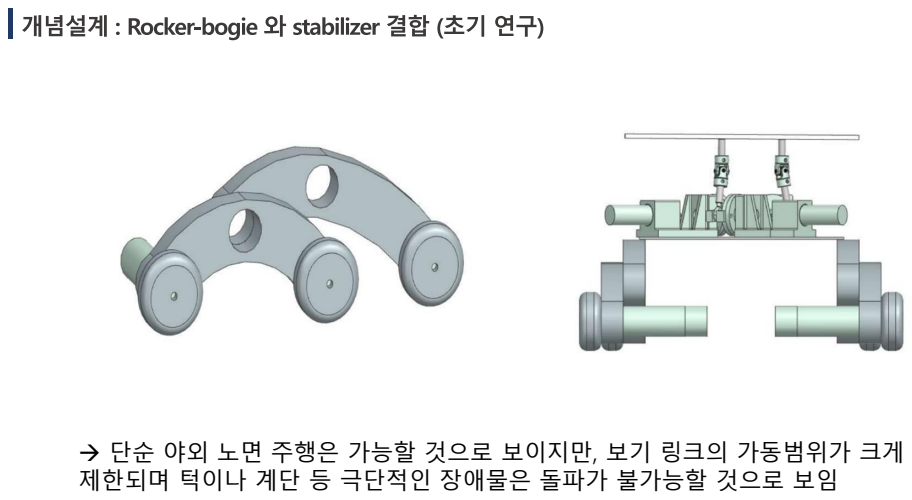
[picture p149: page 38]

→ 단순 야외 노면 주행은 가능할 것으로 보이지만, 보기 링크의 가동범위가 크게
제한되며 턱이나 계단 등 극단적인 장애물은 돌파가 불가능할 것으로 보임

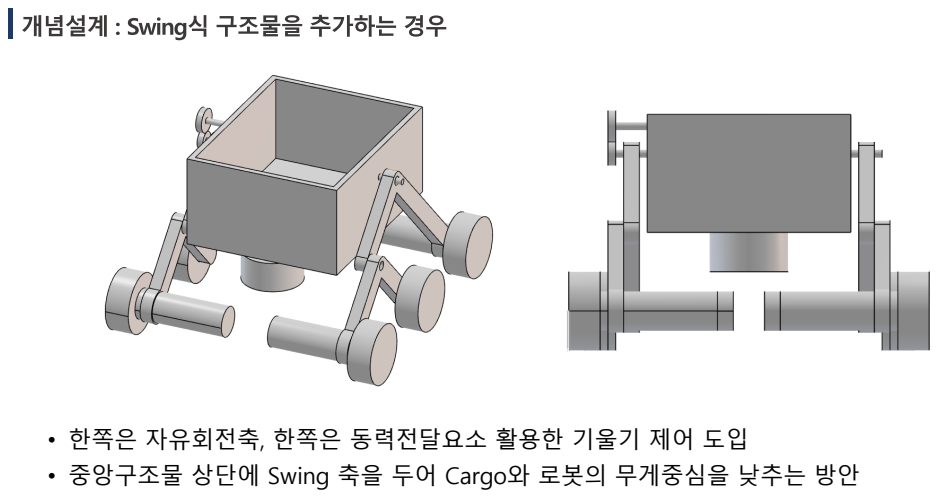
[picture p150: page 39]

• 한쪽은 자유회전축, 한쪽은 동력전달요소 활용한 기울기 제어 도입
• 중앙구조물 상단에 Swing 축을 두어 Cargo와 로봇의 무게중심을 낮추는 방안

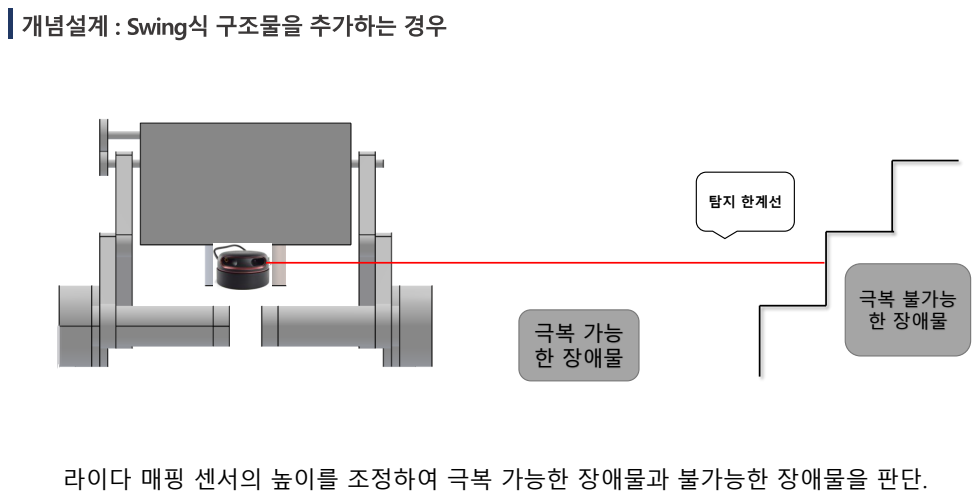
[picture p151: page 40]
극복 가능 한 장애물; 탐지 한계선; 극복 불가능 한 장애물

라이다 매핑 센서의 높이를 조정하여 극복 가능한 장애물과 불가능한 장애물을 판단.

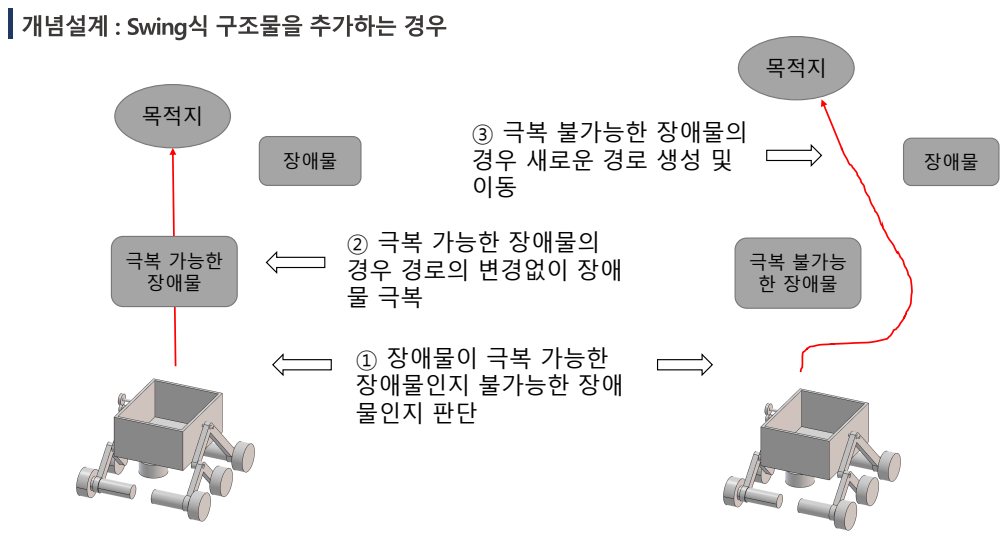
[picture p152: page 41]
극복 가능한 장애물; 극복 불가능 한 장애물; 목적지; 장애물

③ 극복 불가능한 장애물의
경우 새로운 경로 생성 및

② 극복 가능한 장애물의
경우 경로의 변경없이 장애

① 장애물이 극복 가능한
장애물인지 불가능한 장애
물인지 판단


로드맵 및

구분 | 대분류 | 진행 일정
3 | 4 | 5 | 6 | 7 | 8 | 9 | 10 | 11
1 | 2 | 3 | 4 | 1 | 2 | 3 | 4 | 1 | 2 | 3 | 4 | 1 | 2 | 3 | 4 | 1 | 2 | 3 | 4 | 1 | 2 | 3 | 4 | 1 | 2 | 3 | 4 | 1 | 2 | 3 | 4 | 1 | 2 | 3 | 4
제어부 | -로봇 시스템
| - Rocker-bogie
| - Cargo
| - 회로

설계부

구분 | 대분류 | 소분류 | 역할분담
제어부 | -로봇 시스템 | IMU Swing PID | 송종헌, 석영선
| | CCTV+SLAM | 석영선
| | ROS 통합 | 송종헌 , 석영선
| | 라이다 | 석영선
| | 모터제어 | 송종헌
| - Rocker -bogie | 턱 대응 최적화 | 김민재
| | 등판각 대응 최적화 | 송종헌
| | Bogie 형상 | 김민재
| | Wheel 선정, 모터 장착 | 김강현
| - Cargo | Body 설계 | 김민재
| | 축 Swing 설계 2 | 김강현
| | 무게중심해석 | 송종헌
| - 회로 | 모터, 배터리, 문워커 배치 | 김강현
| | NUC -모터 | 김민재
| | IMU | 김강현

설계부

# 참고 문헌 및 사이트

- [1] 성큼 다가 온 '로봇 배달' 시대...넘어야 할 과제는 - 오피니언뉴스 (http://www.opinionnews.co.kr/news/articleView.html?idxno=80956)
- [2] 로봇배달 172조 시장 선점 경쟁력 '충분'…정부 육성안 내달 발표 : 네이트 뉴스 (nate.com) (https://news.nate.com/view/20230222n09662?mid=n0301) (https://news.nate.com/view/20230222n09662?mid=n0301)
- [3] 배달 못하는 '배달로봇'…인도도, 차도도 다닐 수가 없다 (https://www.hankookilbo.com/News/Read/A2021112915470003518)
- [4] 사람 대신 로봇이 배달, 실외 상용화 시대 열리나? (https://economist.co.kr/article/view/ecn202212030017)
- [5] 빅체인지 생활로봇시대 시작되었다
(https://news.mtn.co.kr/news-detail/2022120915065365886)
- [6] 주문따라 조리, 완성되면 서빙…배달도 하는 요즘 로봇 (https://news.sbs.co.kr/news/endPage.do?news_id=N1006549254&plink=ORI&cooper=NAVER)
- [7] 국내 유통업계 최초 실외 주행 로봇 시범 운영 세븐일레븐, 야외형 자율주행 배달 로봇 ‘뉴비’ 도입 (https://economychosun.com/site/data/html_dir/2021/12/11/2021121100017.html)
- [8] '코로나19 시대, 비대면을 위한 배달 로봇’ (https://n.news.naver.com/mnews/article/421/0004824718)

# 참고 문헌 및 사이트

- [9] 길가의 돌·나무조각 안 써도 된다…강남구, 경사주차장 '고임목' 지급 - 경향신문 (khan.co.kr)

( https://m.khan.co.kr/national/national-general/article/202103251853001#c2b)
- [10] 횡단보도가 설치됐으나 차도와 인도를 구분하는 경계석은 여전히 높다.

(http://www.gjtimes.co.kr/news/photoView.html?idxno=17841)

- [11] Deploying on Mars: NASA-JPL Open Source Rover

(https://www.freedomrobotics.com/blog/building-the-nasa-jpl-open-source-rover)

- [12] Sevenoak Carbon Gimbal Swing Panorama Head SK-GH10, 178,33

(https://www.mediaresort.de/Sevenoak-Carbon-Gimbal-Swing-Panorama-Head-SK-GH10)
- [13] 라커-보기 구조를 갖는 카트의 계단 등반 성능 최적화

(CFKO201028451829635.pdf (koreascience.kr)) (https://koreascience.kr/article/CFKO201028451829635.pdf)

- McGraw Hill – Shigly’s Mechanical Engineering Design
